Kenny-Z/ESE516Group/AtmelProject/document/Voodoo Magic.png

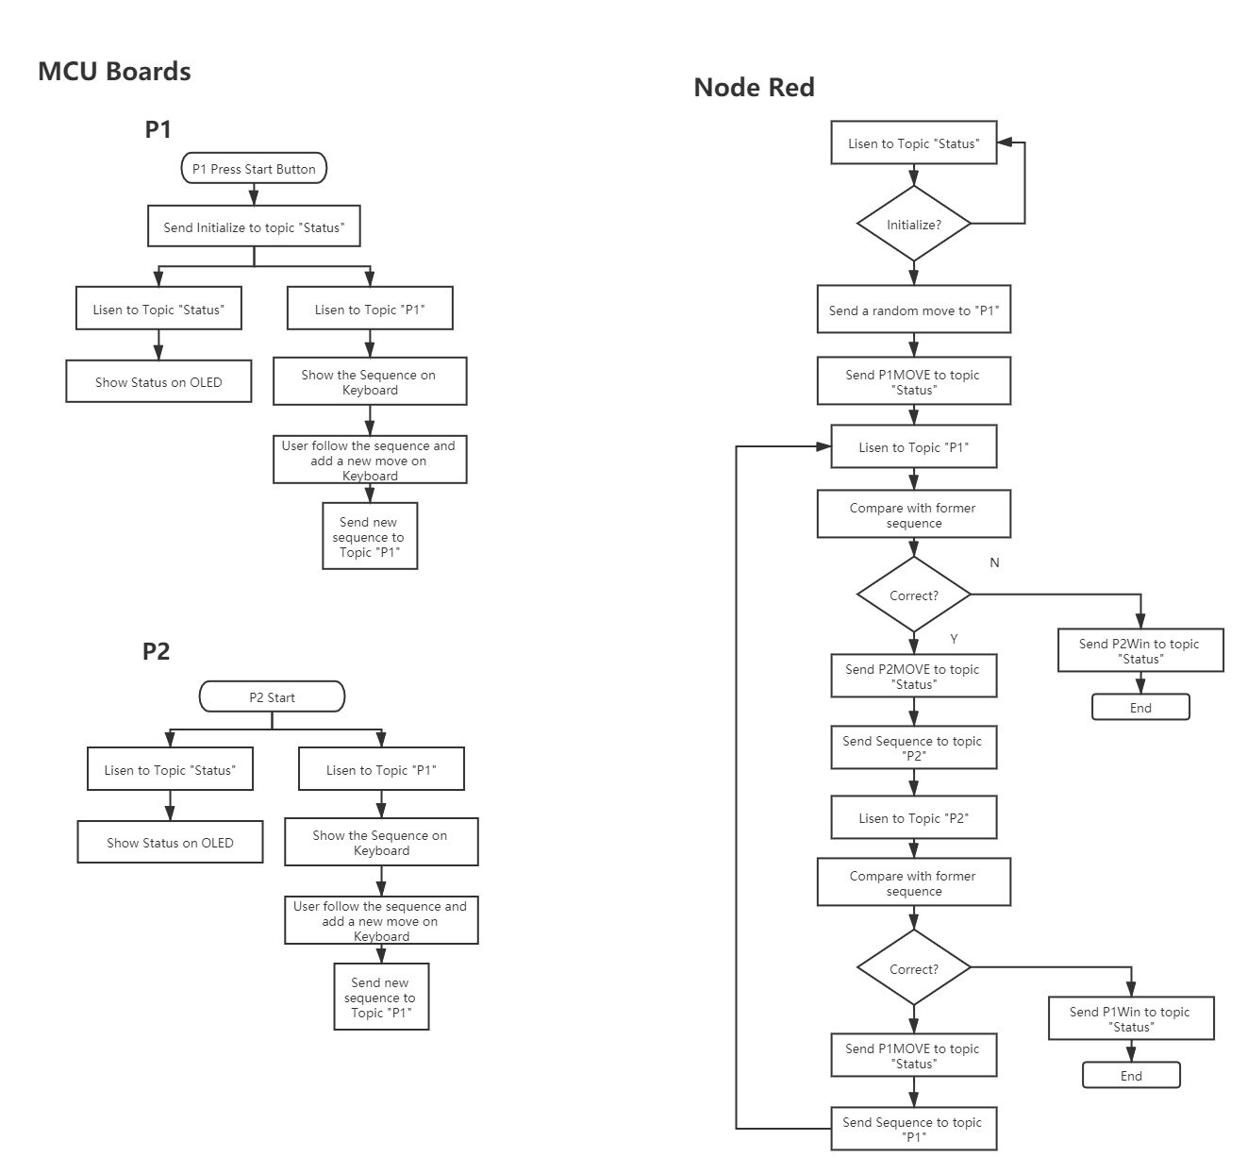
AtmelProject/document/Voodoo Magic.png
