Kenny-Z/ESE516Group/AltuimProject/VoodooMagic/Project Outputs for VoodooMagic/BOM/Bill of Materials-ESE516_ExampleProject.xlsx

Line # | Description | Designator | Quantity | Name | Manufacturer 1 | Manufacturer Part Number 1 | Manufacturer Lifecycle 1 | Supplier 1 | Supplier Part Number 1 | Supplier Unit Price 1 | Supplier Subtotal 1
 | DNP | DNP | 0 | Keypad | Adafruit Industries | 3954 |  | Digi-Key | 1528-2712-ND | 0 | 0
 | DNP | DNP | 0 | OLED Screen | SparkFun | LCD-14532 |  | Digi-Key | 1568-1819-ND | 0 | 0
16 | CAP 100nF 16V ±10% 0603 (1608 Metric) Thickness 1mm SMD | C1, C3, C7, C16 | 4 | 100nF 16V, CAP 100nF 16V 0603(1608) | Yageo | CC0603KRX7R7BB104 | Volume Production | Digi-Key | 311-1088-6-ND | 0.1 | 0.4
7 | CAP 10nF 16V ±10% 0603 (1608 Metric) Thickness 1mm SMD | C2 | 1 | 10nF 16V | Yageo | CC0603KRX7R7BB103 | Volume Production | Digi-Key | 311-3369-1-ND | 0.1 | 0.1
5 | CAP 4.7uF 16V -20% to +80% 0805 (2012 Metric) Thickness 1.45mm SMD | C4, C30, C31 | 3 | 4.7uF 16V | Yageo | CC0805KKX7R8BB475 | Volume Production | Digi-Key | 311-1885-6-ND | 0.42 | 1.26
 | CAP 100pF 50V ±20% 0603 (1608 Metric) Thickness 1mm SMD | C5, C6, C8, C9, C17, C19 | 6 | CAP 100pF 50V | KEMET | C0603C101M5GACTU | Volume Production | Digi-Key | 399-8981-6-ND | 0.1 | 0.6
4 | CAP 1uF 16V ±5% 0603 (1608 Metric) Thickness 1mm SMD | C10, C13, C29 | 3 | 1uF 16V | Yageo | CC0603KRX7R7BB105 | Volume Production | Digi-Key | 311-1446-6-ND | 0.15 | 0.45
8 | CAP 10uF 16V ±10% 0805 (2012 Metric) Thickness 1.45mm SMD | C11, C12 | 2 | 10uF 16V, CAP 10uF 16V 0805(2012) | Kyocera AVX | 0805YD106KAT2A | Volume Production | Digi-Key | 478-5165-1-ND | 0.39 | 0.78
9 | CAP 18pF 16V ±5% 0603 (1608 Metric) Thickness 1mm SMD | C14, C15 | 2 | 18pF 16V | KEMET | C0603C180J4GACTU | Volume Production | Digi-Key | 399-11141-1-ND | 0.25 | 0.5
 | CAP 1nF 10V ±1% 0603 (1608 Metric) Thickness 1mm SMD | C18 | 1 | CAP 1nF 10V | Yageo | CC0603KRX7R7BB102 | Volume Production | Digi-Key | 311-4063-1-ND | 0.1 | 0.1
 | Cap Ceramic, 47 uF, +/- 10%, -55 to 85 degC, 2-Pin SMD (1210), RoHS, Tape and Reel | C20, C21, C26, C27 | 4 | 47uF 16V | Murata | GRM32ER61C476KE15L | Volume Production | Digi-Key | 490-6539-6-ND | 0.63 | 2.52
 | CAP 100nF 10V ±5% 0603 (1608 Metric) Thickness 1mm SMD | C22, C25 | 2 | CAP 100nF 10V, 100nF 10V | Yageo | CC0402KRX7R7BB104 | Volume Production | Digi-Key | 311-1338-6-ND | 0.1 | 0.2
 | CAP 1uF 10V ±10% 0603 (1608 Metric) Thickness 1mm SMD | C23, C24 | 2 | 1uF 10V | Yageo | CC0603KPX7R8BB105 |  | Digi-Key | 13-CC0603KPX7R8BB105DKR-ND | 0.26 | 0.52
 | CAP 8.2nF 10V ±5% 0603 (1608 Metric) Thickness 1mm SMD | C28 | 1 | CAP 8.2nF 10V | Yageo | CC0603KRX7R9BB822 | Volume Production | Digi-Key | 311-1811-1-ND | 0.1 | 0.1
 | CAP 120pF 10V ±10% 0603 (1608 Metric) Thickness 1mm SMD | C32 | 1 | 120pF 10V | Yageo | CC0603KRX7R9BB121 | Volume Production | Digi-Key | 311-4094-1-ND | 0.1 | 0.1
 | Chip Capacitor, 22 uF, +/- 20%, 10 V, -55 to 85 degC, 0603 (1608 Metric), RoHS, Tape and Reel | C33 | 1 | 22uF 10V | TDK | C1608X5R1A226M080AC | Volume Production | Digi-Key | 445-9077-6-ND | 0.49 | 0.49
 | CAP 4.7uF 10V ±10% 0603 (1608 Metric) Thickness 0.55mm SMD | C34 | 1 | 4.7uF 10V | Yageo | CC0805KKX7R9BB225 | Volume Production | Digi-Key | 311-3420-6-ND | 1.06 | 1.06
 | CAP 1uF 10V ±10% 0402 (1005 Metric) Thickness 0.6mm SMD | C35 | 1 | 1uF 10V | Yageo | CC0603KRX7R7BB105 | Volume Production | Digi-Key | 311-1446-6-ND | 0.15 | 0.15
 | CAP 100nF 10V ±5% 0402 (1005 Metric) Thickness 0.6mm SMD | C36, C37 | 2 | 100nF 10V | Yageo | CC0603KRX7R8BB104 | Volume Production | Digi-Key | 311-1341-1-ND | 0.1 | 0.2
30 | LED Uni-Color Red, 100 mW, 200 mA, -55 to 85 degC, 2-Pin SMD, RoHS, Tape and Reel | D1, D4 | 2 | LTST-C170CKT | Vishay Lite-On | LTST-C170CKT | Volume Production | Digi-Key | 160-1176-1-ND | 0.35 | 0.7
34 | Ultra Low Capacitance Double Rail-to-Rail ESD Protection Diode, 5.5 V, 1 pF, -40 to 85 degC, 4-Pin SOT143B, RoHS, Tape and Reel | D2 | 1 | PRTR5V0U2X,215 | Nexperia | PRTR5V0U2X,215 |  | Digi-Key | 1727-3884-6-ND | 0.48 | 0.48
 | LED RED DIFFUSED 0805 SMD | D3 | 1 | LH R974-LP-1 | Osram Opto | LH R974-LP-1 | Volume Production | Digi-Key | 475-1415-1-ND | 0.26 | 0.26
31 | LED Uni-Color Green, 100 mW, 120 mA, -55 to 85 degC, 2-Pin SMD, RoHS, Tape and Reel | D5 | 1 | LTST-C170GKT | Vishay Lite-On | LTST-C170GKT | Volume Production | Digi-Key | 160-1179-1-ND | 0.3 | 0.3
24 | Chip Ferrite Bead for Power Lines, 220 Ohm, 2000 mA, -55 to 125 degC, 2 x 1.25 x 1.05 mm SMD, Tape and Reel | FB1 | 1 | BLM21PG221SN1D | Murata | BLM21PG221SN1D | Volume Production | Digi-Key | 490-1054-6-ND | 0.1 | 0.1
13 | Fiducial 40x100mm | FD1, FD2, FD3 | 3 | 40x100mm
39 | Connector; USBMicro-B,Reverse type, SMT; 5 Position; Right Angle | J1 | 1 | ZX62R-B-5P | Hirose | ZX62R-B-5P(30) | Volume Production | Digi-Key | H125274CT-ND | 1.02 | 1.02
 | BOURNS - SRP6540-1R0M - Cewka mocy (SMD), 1 µH, 12 A, Osloniete, 13.5 A, Seria SRP6540, 7.2mm x 6.5mm x 4mm | L1 | 1 | 1uH |  |  |  | Digi-Key | SRP6540-1R0MCT-ND
 | FIXED IND 470NH 1.2A 90 MOHM SMD | L2 | 1 | 470nH | TDK | MLP2012SR47MT0S1 | Volume Production | Digi-Key | 445-6367-1-ND | 0.33 | 0.33
20 | Male Header, Pitch 2.54 mm, 1 x 3 Position, Height 10.03 mm, Tail Length 3.56 mm, -55 to 105 degC | P1, P5 | 2 | 640456-3 | Molex | 22-11-2032 | Volume Production | Digi-Key | WM2701-ND | 0.53 | 1.06
 | Male Header, Pitch 2.54 mm, 1 x 4 Position, Height 10.03 mm, Tail Length 3.56 mm, RoHS, Bulk | P2, P3, P4 | 3 | 640456-4 | TE Connectivity | 640456-4 | Volume Production | Digi-Key | A1922-ND | 0.24 | 0.72
1 | 0.1" Pad | PB22, PB23, Reset, TP1, TP2, TP3, TP4 5V5, TP5, TP6, TP7, TP9, TP10 3V3, TP11, TP12, TP13, TP14, TP15, TP16, TP17, TP19, TP20, TP21, TP22, TP23, TP24 | 25 | 0.1" Pad | DNP | DNP | DNP | DNP | DNP | DNP
11 | 27R 0.1W 1% 0603 (1608 Metric) SMD | R1, R2, R19, R20, R21 | 5 | 27R 1% | Stackpole Electronics | RMCF0603JT27R0 | Volume Production | Digi-Key | RMCF0603JT27R0DKR-ND | 0.014 | 0.14
3 | 1K 0.1W 1% 0603 (1608 Metric) SMD | R3, R5, R9, R17, R33, R34 | 6 | 1K 1% | Stackpole Electronics | RMCF0603FG1K00 | Volume Production | Digi-Key | RMCF0603FG1K00CT-ND | 0.016 | 0.16
28 | Jumper 0603 (1608 Metric) | R4 | 1 | Jumper | Yageo | RC0603JR-070RL | Volume Production | Digi-Key | 311-0.0GRCT-ND | 0.1 | 0.1
29 | Jumper 0805 (2012 Metric) | R6, R7, R8, R14, R15, R16, R18 | 7 | Jumper | Yageo | RC0805JR-070RL | Volume Production | Digi-Key | 311-0.0ARDKR-ND | 0.031 | 0.31
 | 4K7 0.063W 1% 0402 (1005 Metric) SMD | R10, R11, R12, R13 | 4 | 4K7 1% | Stackpole Electronics | RMCF0402FT4K70 | Volume Production | Arrow Electronics | RMCF0402FT4K70 | 0.021 | 0.084
 | Chip Resistor, 10 KOhm, +/- 1%, 0.1 W, -55 to 155 degC, 0603 (1608 Metric), RoHS, Tape and Reel | R22, R24, R26, R27 | 4 | ERJ3EKF1002V | Stackpole Electronics | RMCF0402FT10K0 | Volume Production | Digi-Key | RMCF0402FT10K0CT-ND | 0.014 | 0.14
17 | 100R 0.1W 1% 0603 (1608 Metric) SMD | R23, R25 | 2 | 100R 1% | Stackpole Electronics | RMCF0603FG100R | Volume Production | Digi-Key | RMCF0603FG100RCT-ND | 0.016 | 0.16
 | 23K7 0.063W 1% 0402 (1005 Metric) SMD | R28 | 1 | 23K7 1% | Stackpole Electronics | RMCF0603FT23K7 | Volume Production | Digi-Key | RMCF0603FT23K7DKR-ND | 0.1 | 0.1
 | 86K6 0.063W 1% 0402 (1005 Metric) SMD | R29 | 1 | 86K6 1% | Stackpole Electronics | RMCF0402FT86K6 | Volume Production | Digi-Key | RMCF0402FT86K6DKR-ND | 0.1 | 0.1
 | 140K 0.063W 1% 0402 (1005 Metric) SMD | R30 | 1 | 140K 1% | Stackpole Electronics | RMCF0402FT140K | Volume Production | Digi-Key | 738-RMCF0402FT140KCT-ND | 0.1 | 0.1
 | 309K 0.063W 1% 0402 (1005 Metric) SMD | R31 | 1 | 309K 1% | Stackpole Electronics | RMCF0402FT309K | Volume Production | Digi-Key | RMCF0402FT309KDKR-ND | 0.1 | 0.1
 | 453K 0.063W 1% 0402 (1005 Metric) SMD | R32, R37 | 2 | 453K 1% | Stackpole Electronics | RMCF0402FT453K | Volume Production | Digi-Key | RMCF0402FT453KDKR-ND | 0.014 | 0.14
2 | 1K13 0.1W 1% 0603 (1608 Metric) SMD | R35, R36 | 2 | 1K13 1% | Stackpole Electronics | RMCF0603FT1K13 | Volume Production | Digi-Key | RMCF0603FT1K13DKR-ND | 0.016 | 0.16
 | 100K 0.063W 1% 0402 (1005 Metric) SMD | R38, R39 | 2 | 100K 1% 0402 | Stackpole Electronics | RMCF0402FT100K | Volume Production | Digi-Key | RMCF0402FT100KDKR-ND | 0.014 | 0.14
 | 10R 0.063W 1% 0402 (1005 Metric) SMD | R40 | 1 | 10R 1% | Stackpole Electronics | RMCF0402JT10R0 | Volume Production | Arrow Electronics | RMCF0402JT10R0 | 0.0132 | 0.0132
 | RES Thick Film, 10kΩ, 1%, 0.063W, 100ppm/°C, 0402 | R41 | 1 | 10k 1% | Stackpole Electronics | RMCF0402FT10K0 | Volume Production | Digi-Key | RMCF0402FT10K0DKR-ND | 0.1 | 0.1
19 | Micro SD Card, RA, -25 to 85 degC, 8-Pin SMD, RoHS, Tape and Reel | SD1 | 1 | 104031-0811 | Molex | 1040310811 | Volume Production | Digi-Key | WM6357DKR-ND | 1.83 | 1.83
 | SWITCH TACTILE SPST-NO 0.05A 16V | SW1, SW2 | 2 | PTS810 SJG 250 SMTR LFS | ITT C&K | PTS810SJG250SMTRLFS | Volume Production | Digi-Key | CKN10504CT-ND | 0.37 | 0.74
27 | FT234XD USB to BASIC UART IC, -40 to +85 degC, 12-Pin DFN, Pb-Free, Tape and Reel | U1 | 1 | FT234XD-R | FTDI | FT234XD-R | Volume Production | Digi-Key | 768-1178-1-ND | 2.04 | 2.04
21 | CONN HEADER 10POS UNSHD VERT T/H | U2 | 1 | 20021111-00010T4LF | Amphenol FCI | 20021111-00010T4LF | Volume Production | Digi-Key | 609-3712-ND | 0.73 | 0.73
36 | RF TXRX MODULE WIFI TRACE ANT | U3 | 1 | SAMW25H18-MR510PB | Microchip / Atmel | ATSAMW25H18-MR510PB | Volume Production | Digikey | ATSAMW25H18-MR510PB-ND
 | IC REG BOOST ADJ 10A 20VQFN | U4 | 1 | TPS61088RHLT | Texas Instruments | TPS61088RHLT | New Product | Digi-Key | 296-42129-1-ND | 4.55 | 4.55
 | USB-Friendly Li-Ion Battery Charger and Power-Path Management IC, Vout 5.5 V, 4.3 V, -40 to 85 degC, 16-pin QFN (RGT), Green (RoHS & no Sb/Br) | U5 | 1 | BQ24075RGTR | Texas Instruments | BQ24075RGTR | Volume Production | Digi-Key | 296-38874-6-ND | 2.19 | 2.19
 | 2.4V-5.5V input, 4A step-down converter with 1% Accuracy in 1.5mm x 1.5mm QFN 6-VSON-HR -40 to 125 | U6 | 1 | TPS62827DMQR | Texas Instruments | TPS62827DMQR |  | Digi-Key | 296-TPS62827DMQRCT-ND
 | Sensor Controller Capacitive 3-CH I2C 8-Pin SOIC T/R | U7 | 1 | I2C Touch Sensor | Microchip | CAP1203-1-SN-TR | Not Recommended for New Design | Digi-Key | CAP1203-1-SN-CT-ND | 0.55 | 0.55
 | HIGH ACCURACY AMBIENT LIGHT SENS | U8 | 1 | I2C Light Sensor | Vishay Semiconductors | VEML6030-GS15 |  | Digi-Key | VEML6030-GS15CT-ND | 2 | 2
22 | Crystal, 32.768 kHz, 12.5 pF, -40 to 85 degC, SMD Low Profile 3.2 x 1.5 x 0.9 mm, Tape and Reel | X1 | 1 | ABS07-32.768KHz-T | Micro Crystal | CC7V-T1A-32.768KHZ-12.5PF-20PPM-TA-QC |  | Digi-Key | 2195-CC7V-T1A-32.768KHZ-12.5PF-20PPM-TA-QCCT-ND | 0.61 | 0.61
