Kenny-Z/ESE516Group/AltuimProject/VoodooMagic/Project Outputs for VoodooMagic/VoodooMagic_V1_Documentation.PDF

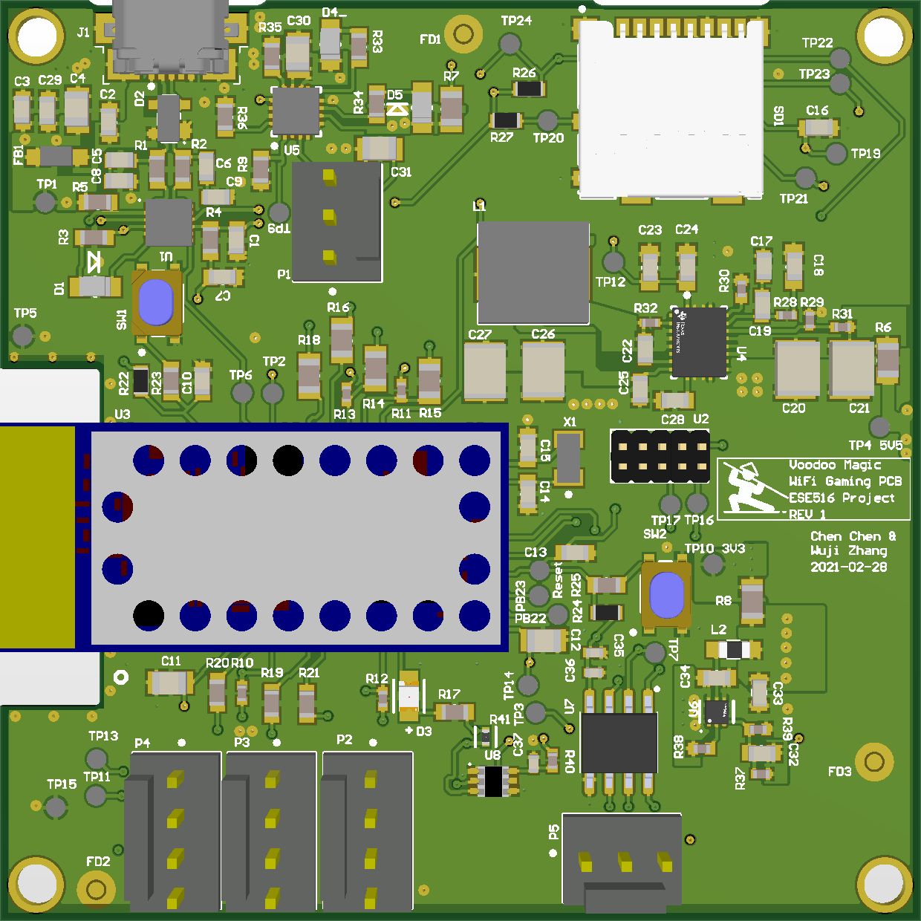
[picture p45: page 1]

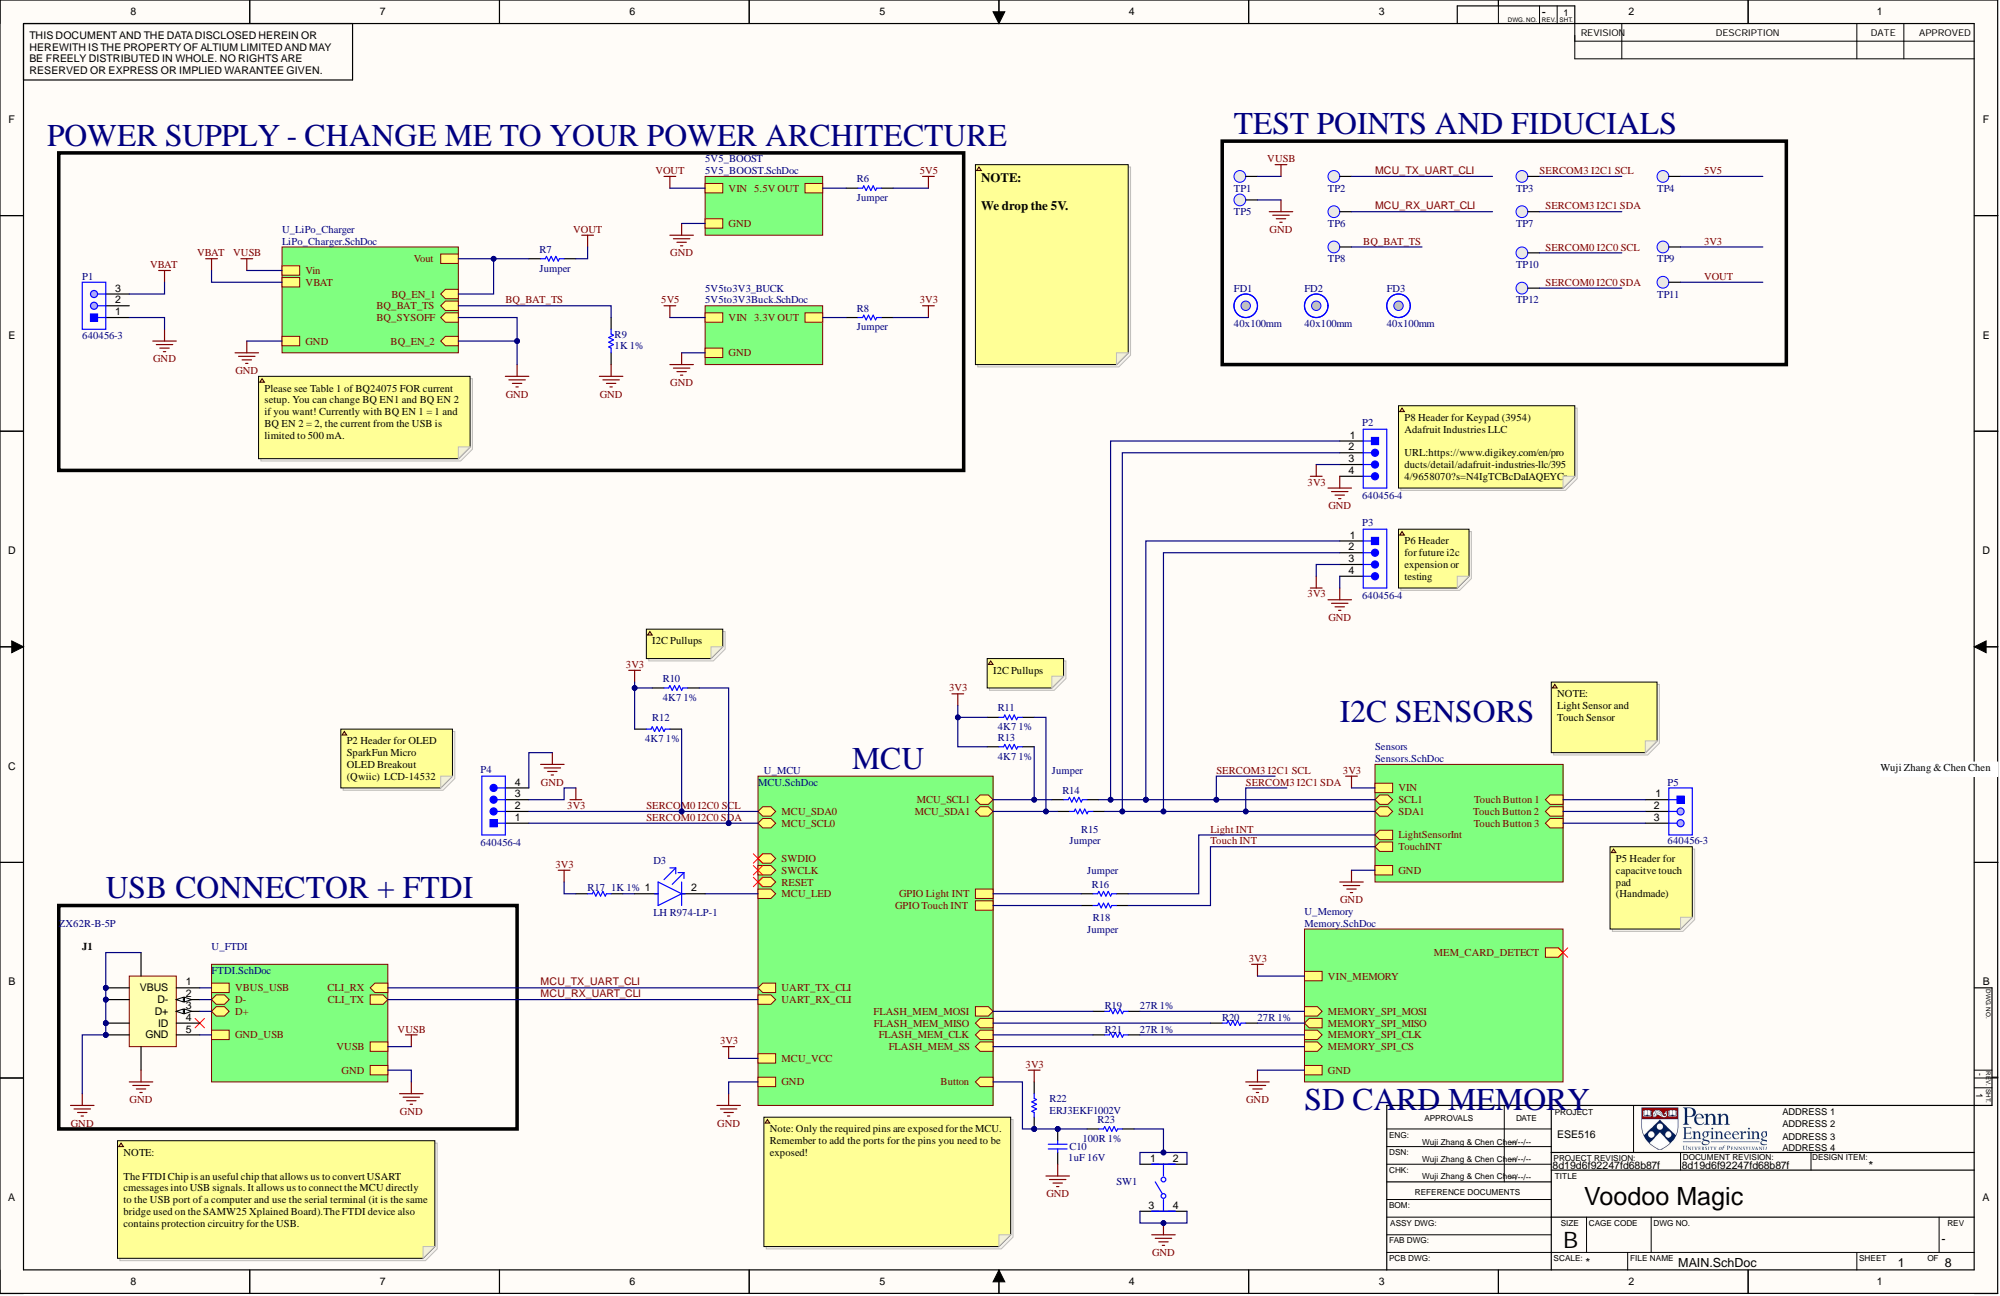
[picture p46: page 2]

DWG. NO. | -REV. | 1 SHT.

THIS DOCUMENT AND THE DATA DISCLOSED HEREIN OR HEREWITH IS THE PROPERTY OF ALTIUM LIMITED AND MAY BE FREELY DISTRIBUTED IN WHOLE. NO RIGHTS ARE RESERVED OR EXPRESS OR IMPLIED WARANTEE GIVEN. POWER SUPPLY - CHANGE ME TO YOUR POWER ARCHITECTURE | TEST POINTS AND FIDUCIALS | REVISION | DESCRIPTION | DATE | APPROVED

GND
Please see Table 1 of BQ24075 FOR current
setup. You can change BQ EN1 and BQ EN 2
if you want! Currently with BQ EN 1 = 1 and
BQ EN 2 = 2, the current from the USB is
limited to 500 mA.

URL:https://www.digikey.com/en/pro
ducts/detail/adafruit-industries-llc/395
4/9658070?s=N4IgTCBcDaIAQEYCs

SERCOM3 I2C1 SCL | 3

Wuji Zhang & Chen Chen

REV. SHT. DWG. NO.

Note: Only the required pins are exposed for the MCU.
Remember to add the ports for the pins you need to be
exposed!

DSN: Wuji Zhang & Chen Chen | --/--/--

8d19d6f92247fd68b87f | DOCUMENT REVISION: 8d19d6f92247fd68b87f | DESIGN ITEM: * PROJECT REVISION:

CHK: Wuji Zhang & Chen Chen | --/--/--

The FTDI Chip is an useful chip that allows us to convert USART
cmessages into USB signals. It allows us to connect the MCU directly
to the USB port of a computer and use the serial terminal (it is the same
bridge used on the SAMW25 Xplained Board).The FTDI device also
contains protection circuitry for the USB.

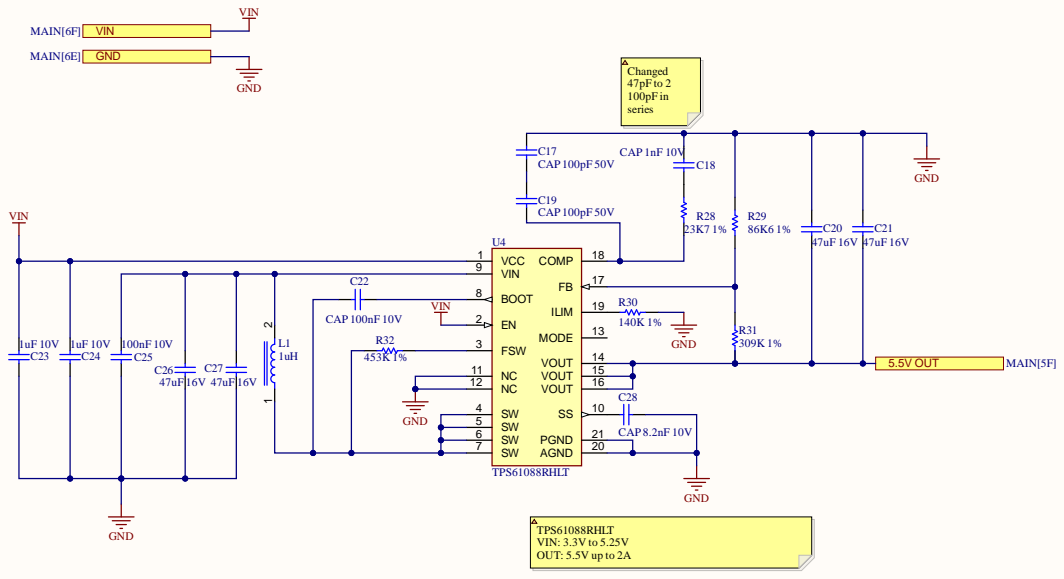
[picture p47: page 3]

DWG. NO. | -REV. | 2 SHT.

THIS DOCUMENT AND THE DATA DISCLOSED HEREIN OR HEREWITH IS THE PROPERTY OF ALTIUM LIMITED AND MAY BE FREELY DISTRIBUTED IN WHOLE. NO RIGHTS ARE RESERVED OR EXPRESS OR IMPLIED WARANTEE GIVEN. | | REVISION | DESCRIPTION | DATE | APPROVED

R32
453K 1% | NC 11

REV. SHT. DWG. NO.

DATE | PROJECT * | ADDRESS 1 ADDRESS 2 APPROVALS ADDRESS 3 ADDRESS 4

ENG: * | --/--/--

DSN: Wuji Zhang | --/--/--

8d19d6f92247fd68b87f | DOCUMENT REVISION: 8d19d6f92247fd68b87f | DESIGN ITEM: * PROJECT REVISION:

CHK: Wuji Zhang | --/--/--

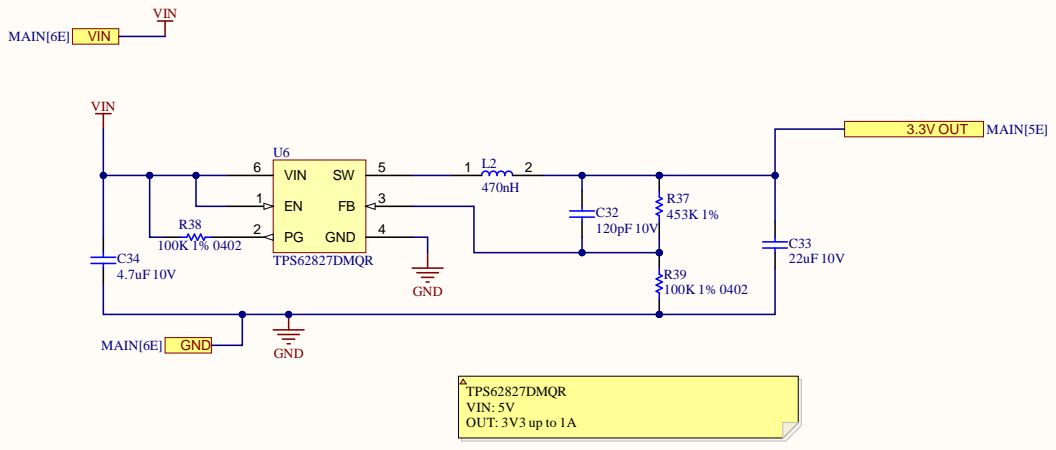
[picture p48: page 4]

DWG. NO. | -REV. | 3 SHT.

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

REV. SHT. DWG. NO.

DATE | PROJECT * | ADDRESS 1 ADDRESS 2 APPROVALS ADDRESS 3 ADDRESS 4

ENG: Wuji Zhang | --/--/--

DSN: Wuji Zhang | --/--/--

8d19d6f92247fd68b87f | DOCUMENT REVISION: 8d19d6f92247fd68b87f | DESIGN ITEM: * PROJECT REVISION:

CHK: Wuji Zhang | --/--/--

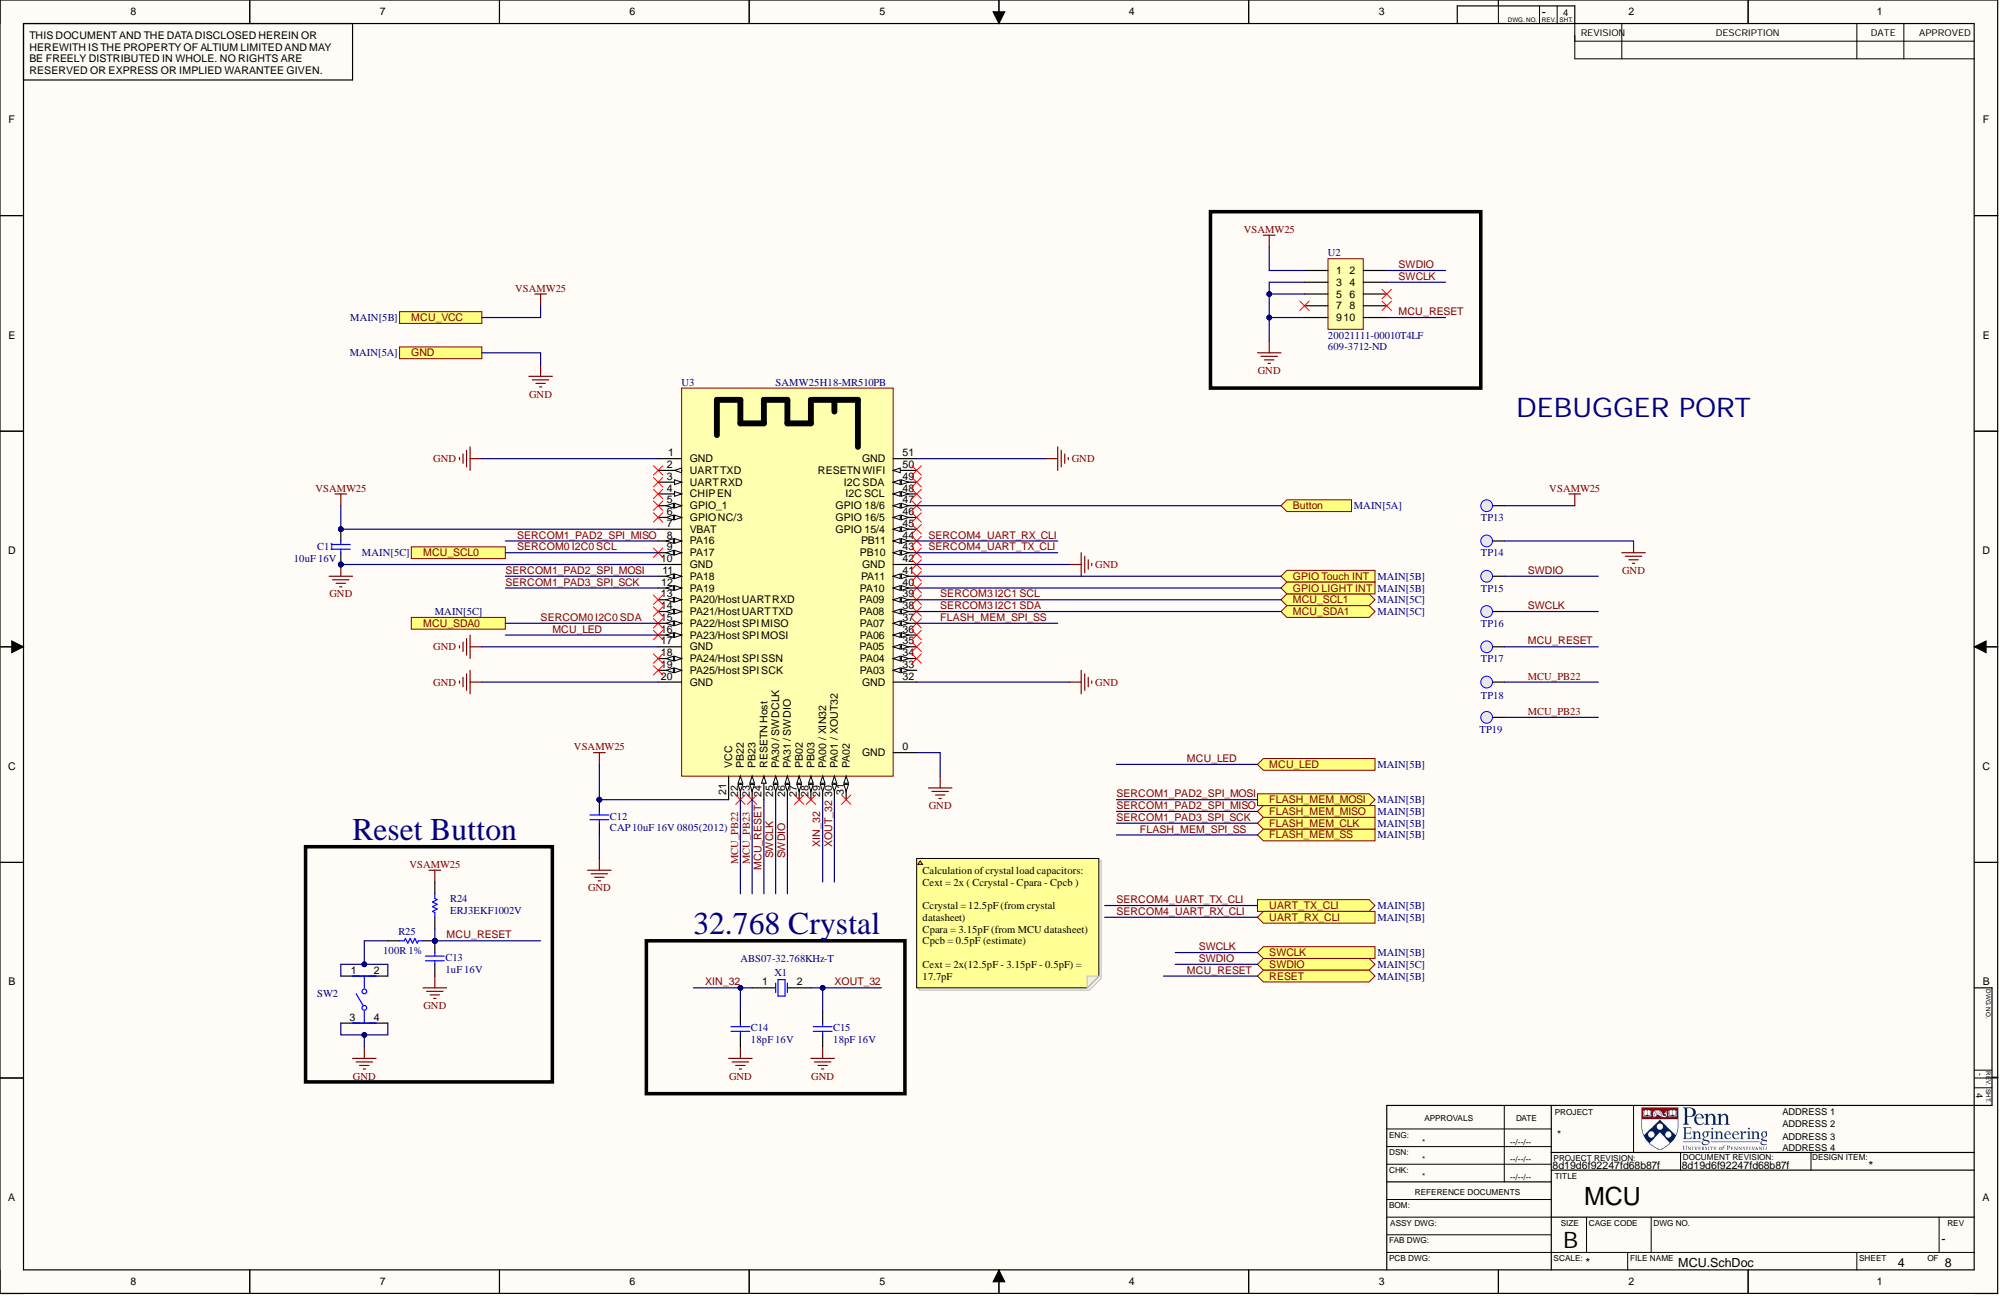
[picture p49: page 5]

DWG. NO. | -REV. | 4 SHT.

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

GPIO Touch INT MAIN[5B]
GPIO LIGHT INT MAIN[5B]

Calculation of crystal load capacitors:
Cext = 2x ( Ccrystal - Cpara - Cpcb )

Ccrystal = 12.5pF (from crystal
datasheet)
Cpara = 3.15pF (from MCU datasheet)
Cpcb = 0.5pF (estimate)

REV. SHT. DWG. NO.

DATE | PROJECT * | ADDRESS 1 ADDRESS 2 APPROVALS ADDRESS 3 ADDRESS 4

ENG: * | --/--/--

DSN: * | --/--/--

8d19d6f92247fd68b87f | DOCUMENT REVISION: 8d19d6f92247fd68b87f | DESIGN ITEM: * PROJECT REVISION:

CHK: * | --/--/--

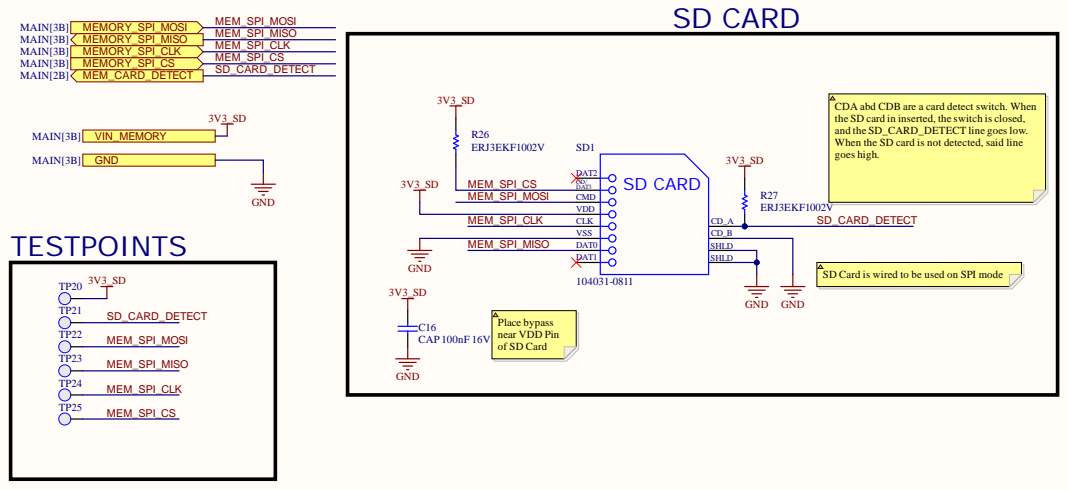
[picture p50: page 6]

DWG . N O . | -R E V | 5 . S H T.

T H IS DOC U MEN T AN D T HE ATA ISCLOSED HEREI N OR HEREW I T H IS T HE PROPER TY OF ALT I U M LI M I TED AN M AY BE F REELY IST R IBU TED I N W HOLE. NO R IGH TS ARE RESERVED OR EXPRESS OR I MPLIED WARAN TEE GIVEN . | | REVISI O N | DESC R IPT I O N | DAT E | APPR OVED

REV. SHT. DWG. NO.

DATE | PRO JECT * | AD D RESS 1 2 APPROVALS AD D RESS AD D RESS 3 AD D RESS 4

ENG : Wu j i Zh a n g | --/--/--

DSN: Wu j i Zh a n g | --/--/--

8d19d6f92247fd68b 8 7 f | DOCUMENT REVISION: 8d19d6f92247fd68b 8 7 f | DESIGN ITEM: * PROJECT REVISION:

CHK: Wu j i Zh a n g | --/--/--

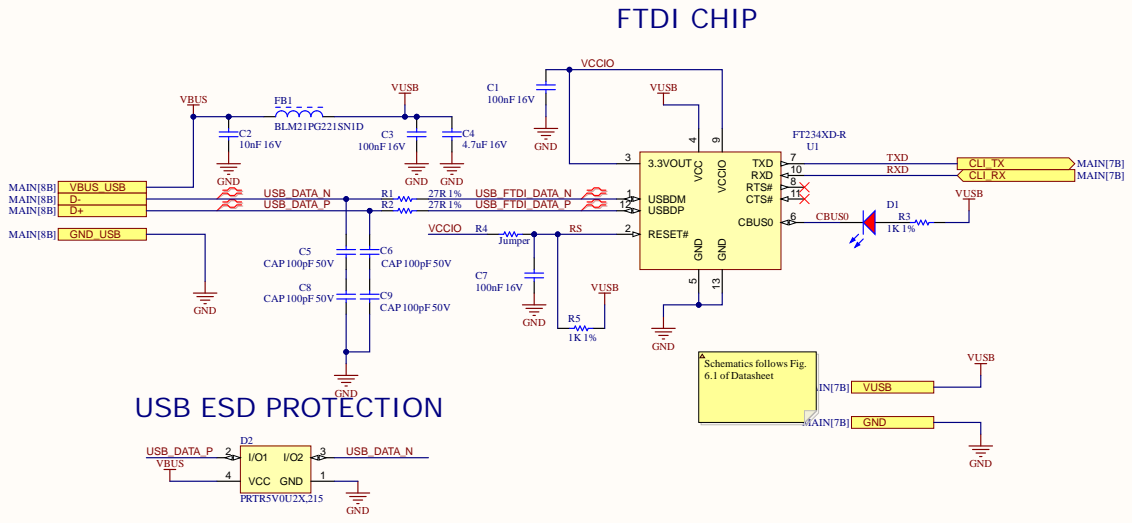
[picture p51: page 7]

DWG. NO. | -REV. | 6 SHT.

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

REV. SHT. DWG. NO.

DATE | PROJECT * | ADDRESS 1 ADDRESS 2 APPROVALS ADDRESS 3 ADDRESS 4

ENG: Wuji Zhang | --/--/--

DSN: Wuji Zhang | --/--/--

8d19d6f92247fd68b87f | DOCUMENT REVISION: 8d19d6f92247fd68b87f | DESIGN ITEM: * PROJECT REVISION:

CHK: Wuji Zhang | --/--/--

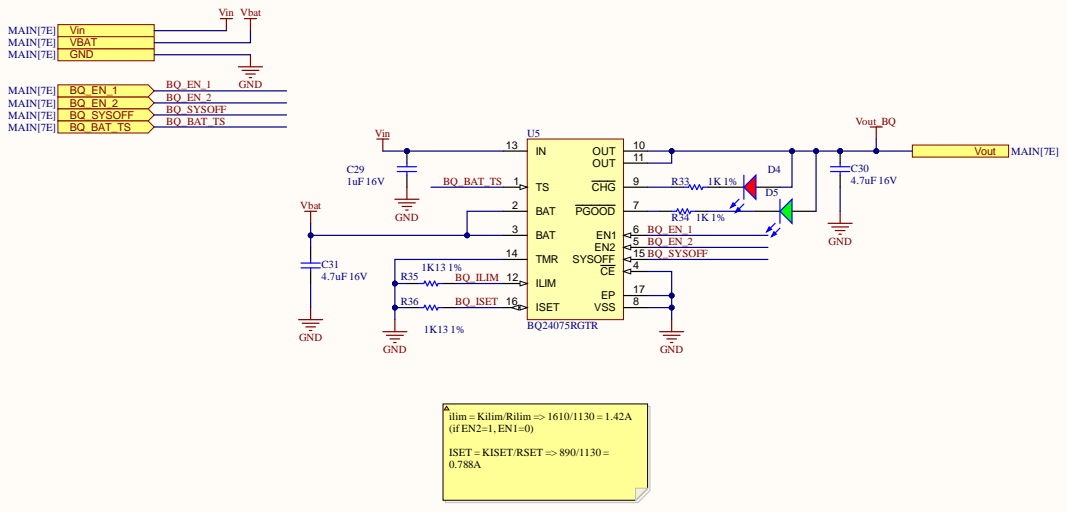
[picture p52: page 8]

DWG . N O . | -R E V | 7 . S H T.

T H IS DOC U MEN T AN T HE ATA ISCLOSED HEREI N OR HEREW I T H IS T HE PROPER TY OF ALT I U M LI M I TED AN M AY BE F REELY IST R IBU TED I N W HOLE. NO R IGH TS ARE RESERVED OR EXPRESS OR I MPLIED WARAN TEE GIVEN . | | REVISI O N | DESC R IPT I O N | DAT E | APPR OVED

1 K 1 3 1 % R3 5 BQ _ILIM

REV. SHT. DWG. NO.

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

ENG : Wu j i Zh a n g | --/--/--

DSN: Wu j i Zh a n g | --/--/--

8d19d6f92247fd68b 8 7 f | DOCUMENT REVISION: 8d19d6f92247fd68b 8 7 f | DESIGN ITEM: * PROJECT REVISION:

CHK: Wu j i Zh a n g | --/--/--

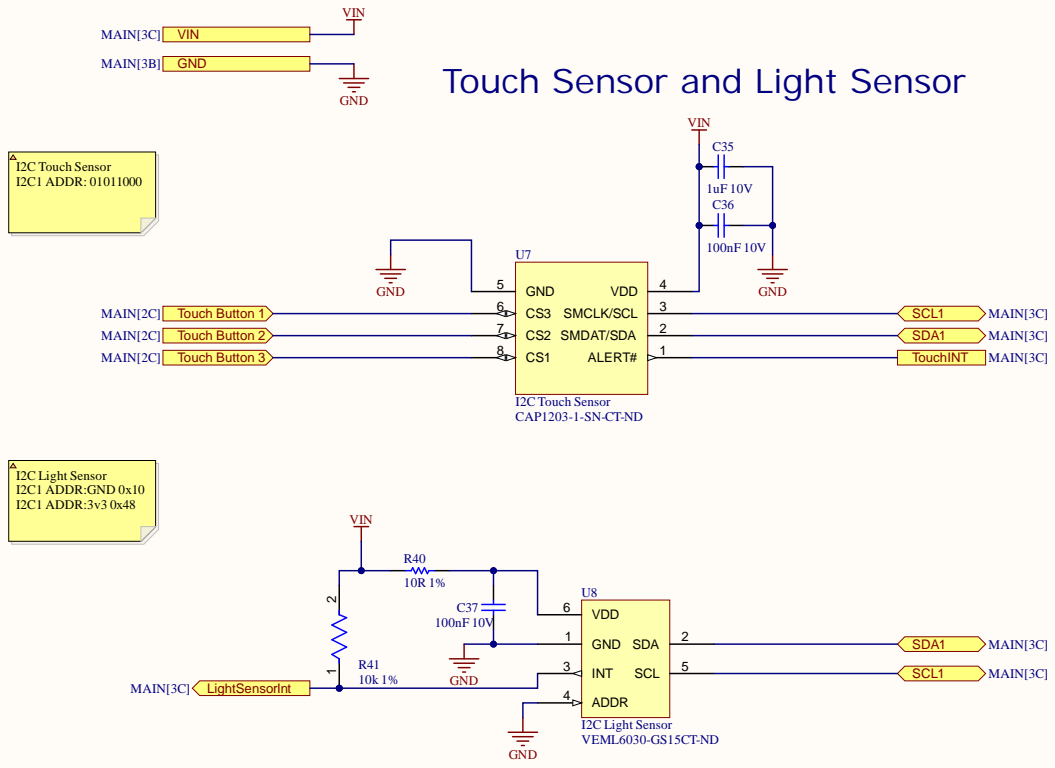
[picture p53: page 9]

DWG. NO. | -REV. | 8 SHT.

THIS DOCUMENT AND THE DATA DISCLOSED HEREIN OR HEREWITH IS THE PROPERTY OF ALTIUM LIMITED AND MAY BE FREELY DISTRIBUTED IN WHOLE. NO RIGHTS ARE RESERVED OR EXPRESS OR IMPLIED WARANTEE GIVEN. | VIN | REVISION | DESCRIPTION | DATE | APPROVED

Touch Sensor and Light Sensor

REV. SHT. DWG. NO.

DATE | PROJECT * | ADDRESS 1 ADDRESS 2 APPROVALS ADDRESS 3 ADDRESS 4

ENG: Wuji Zhang | --/--/--

DSN: Wuji Zhang | --/--/--

8d19d6f92247fd68b87f | DOCUMENT REVISION: 8d19d6f92247fd68b87f | DESIGN ITEM: * PROJECT REVISION:

CHK: Wuji Zhang | --/--/--

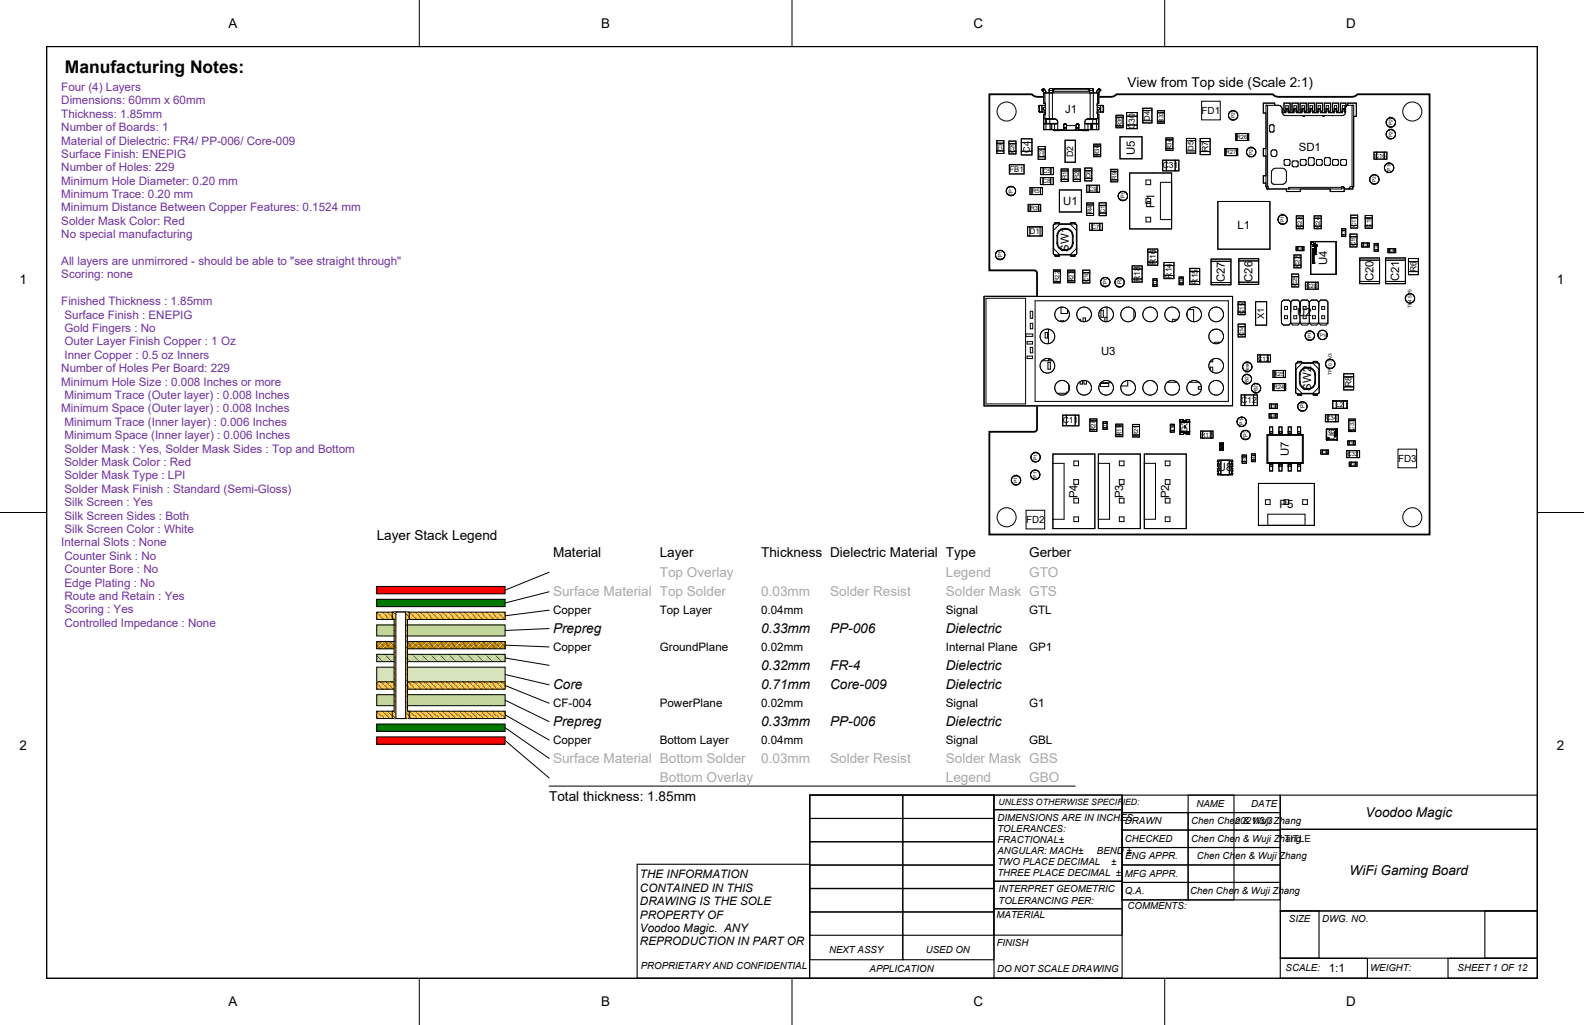
[picture p54: page 10]

Manufacturing Notes:
Four (4) Layers
Dimensions: 60mm x 60mm
Thickness: 1.85mm
Number of Boards: 1
Material of Dielectric: FR4/ PP-006/ Core-009
Surface Finish: ENEPIG
Number of Holes: 229

View from Top side (Scale 2:1)

Minimum Hole Diameter: 0.20 mm
Minimum Trace: 0.20 mm
Minimum Distance Between Copper Features: 0.1524 mm
Solder Mask Color: Red
No special manufacturing

All layers are unmirrored - should be able to "see straight through"
Scoring: none

Finished Thickness : 1.85mm
Surface Finish : ENEPIG
Gold Fingers : No
Outer Layer Finish Copper : 1 Oz
Inner Copper : 0.5 oz Inners
Number of Holes Per Board: 229
Minimum Hole Size : 0.008 Inches or more
Minimum Trace (Outer layer) : 0.008 Inches
Minimum Space (Outer layer) : 0.008 Inches
Minimum Trace (Inner layer) : 0.006 Inches
Minimum Space (Inner layer) : 0.006 Inches

Solder Mask : Yes, Solder Mask Sides : Top and Bottom
Solder Mask Color : Red
Solder Mask Type : LPI
Solder Mask Finish : Standard (Semi-Gloss)
Silk Screen : Yes
Silk Screen Sides : Both
Silk Screen Color : White
Internal Slots : None
Counter Sink : No
Counter Bore : No
Edge Plating : No
Route and Retain : Yes
Scoring : Yes
Controlled Impedance : None

UNLESS OTHERWISE SPECIFIED: | | NAME | DATE | Voodoo Magic
DIMENSIONS ARE IN INCHES TOLERANCES: FRACTIONAL± ANGULAR: MACH± BEND ± TWO PLACE DECIMAL ± THREE PLACE DECIMAL ± | DRAWN | Chen Chen & Wuji Zhang | 2021/3/3

CHECKED | Chen Chen & Wuji Zhang | | TITLE WiFi Gaming Board
ENG APPR. | Chen Chen & Wuji Zhang

THE INFORMATION CONTAINED IN THIS DRAWING IS THE SOLE PROPERTY OF Voodoo Magic. ANY REPRODUCTION IN PART OR PROPRIETARY AND CONFIDENTIAL | | | MFG APPR.

INTERPRET GEOMETRIC TOLERANCING PER: | Q.A. | Chen Chen & Wuji Zhang

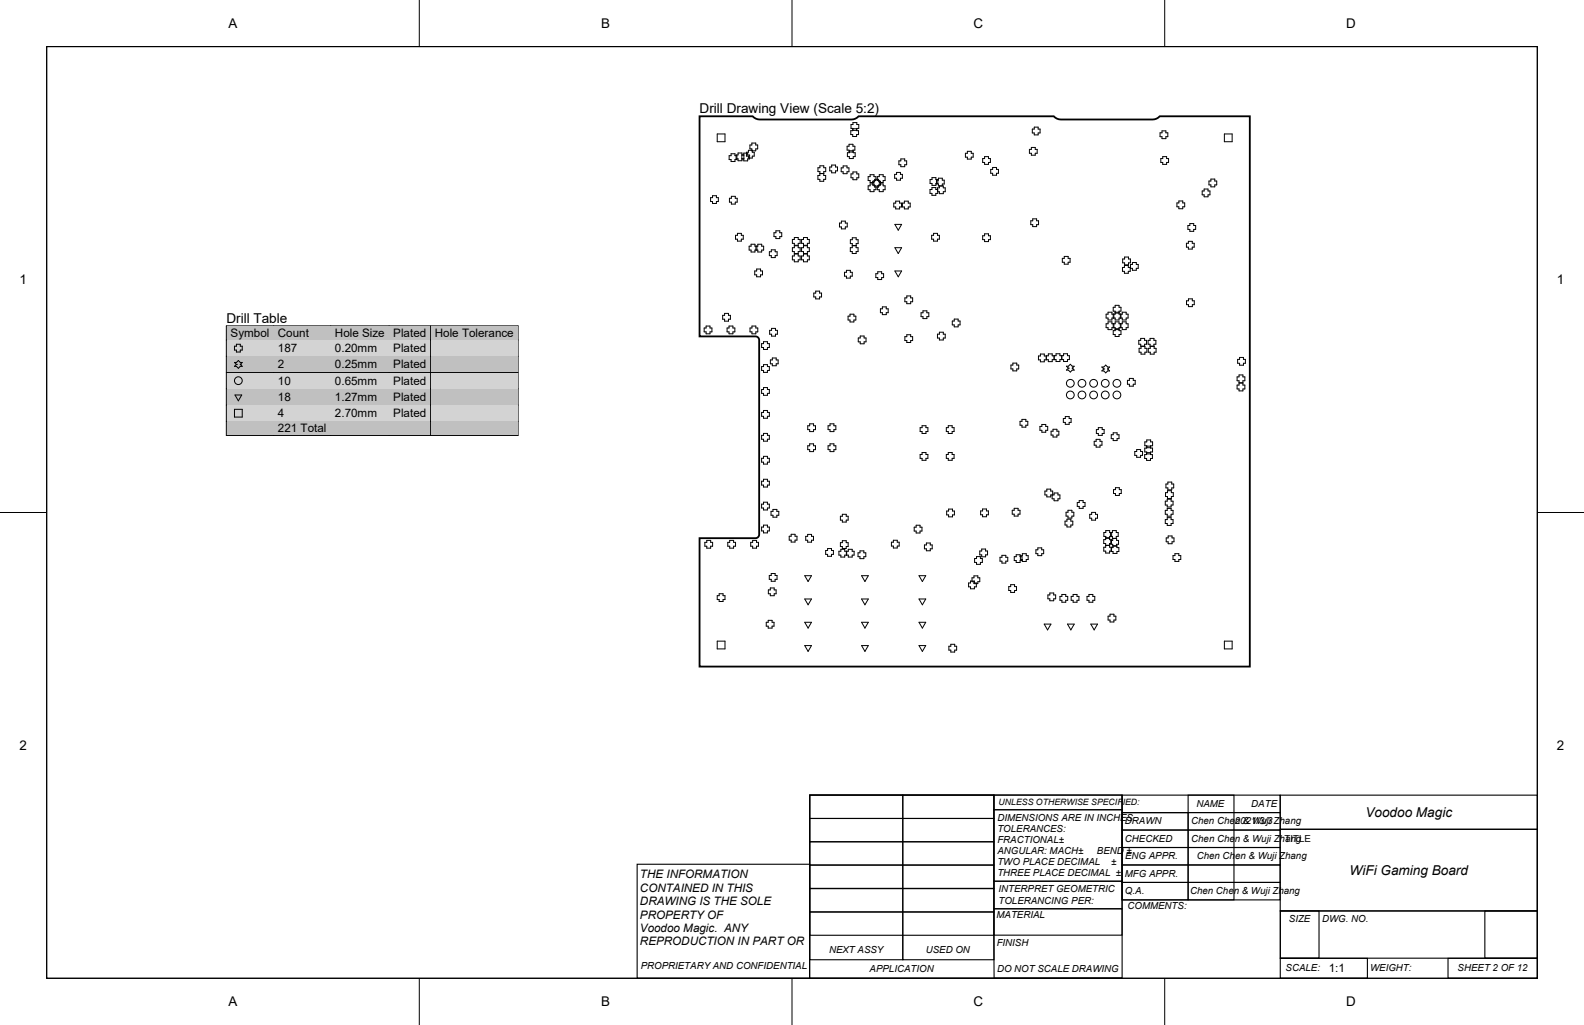
[picture p55: page 11]

Drill Drawing View (Scale 5:2)

Symbol | Count | Hole Size | Plated | Hole Tolerance

187 | 0.20mm | Plated
2 | 0.25mm | Plated
10 | 0.65mm | Plated
18 | 1.27mm | Plated
4 | 2.70mm | Plated
221 Total

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

CHECKED | Chen Chen & Wuji Zhang | | TITLE WiFi Gaming Board
ENG APPR. | Chen Chen & Wuji Zhang

THE INFORMATION CONTAINED IN THIS DRAWING IS THE SOLE PROPERTY OF Voodoo Magic. ANY | | | MFG APPR.

INTERPRET GEOMETRIC TOLERANCING PER: | Q.A. | Chen Chen & Wuji Zhang

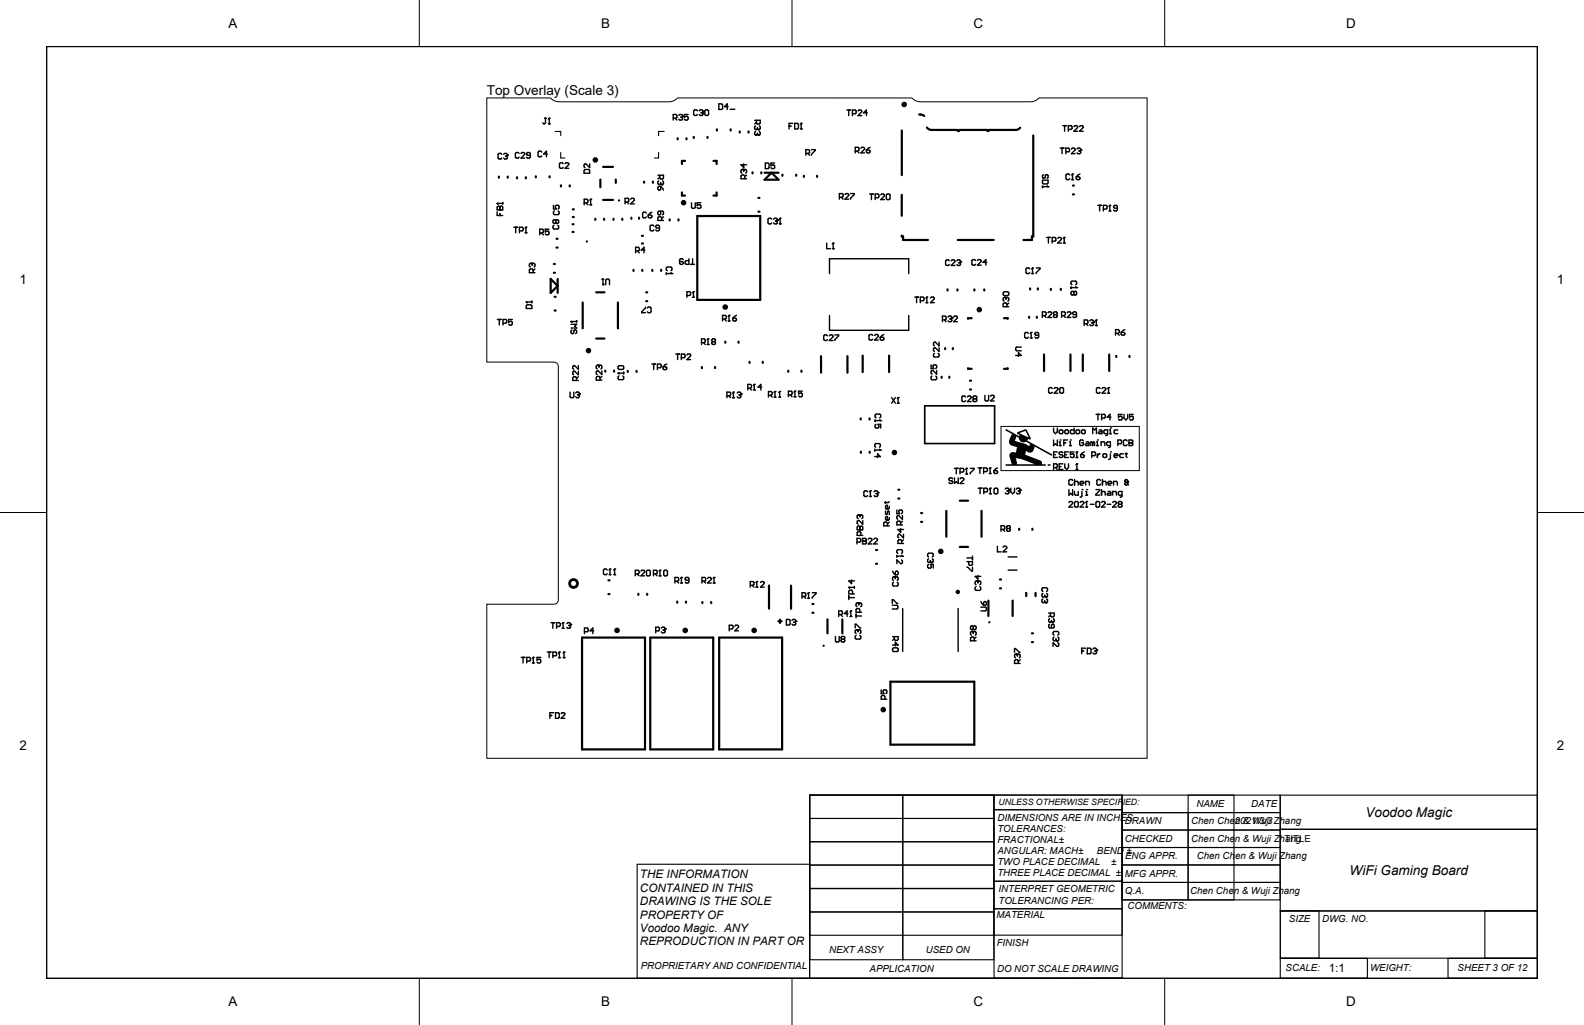
[picture p56: page 12]
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

CHECKED | Chen Chen & Wuji Zhang | | TITLE WiFi Gaming Board
ENG APPR. | Chen Chen & Wuji Zhang

THE INFORMATION CONTAINED IN THIS DRAWING IS THE SOLE PROPERTY OF Voodoo Magic. ANY | | | MFG APPR.

INTERPRET GEOMETRIC TOLERANCING PER: | Q.A. | Chen Chen & Wuji Zhang

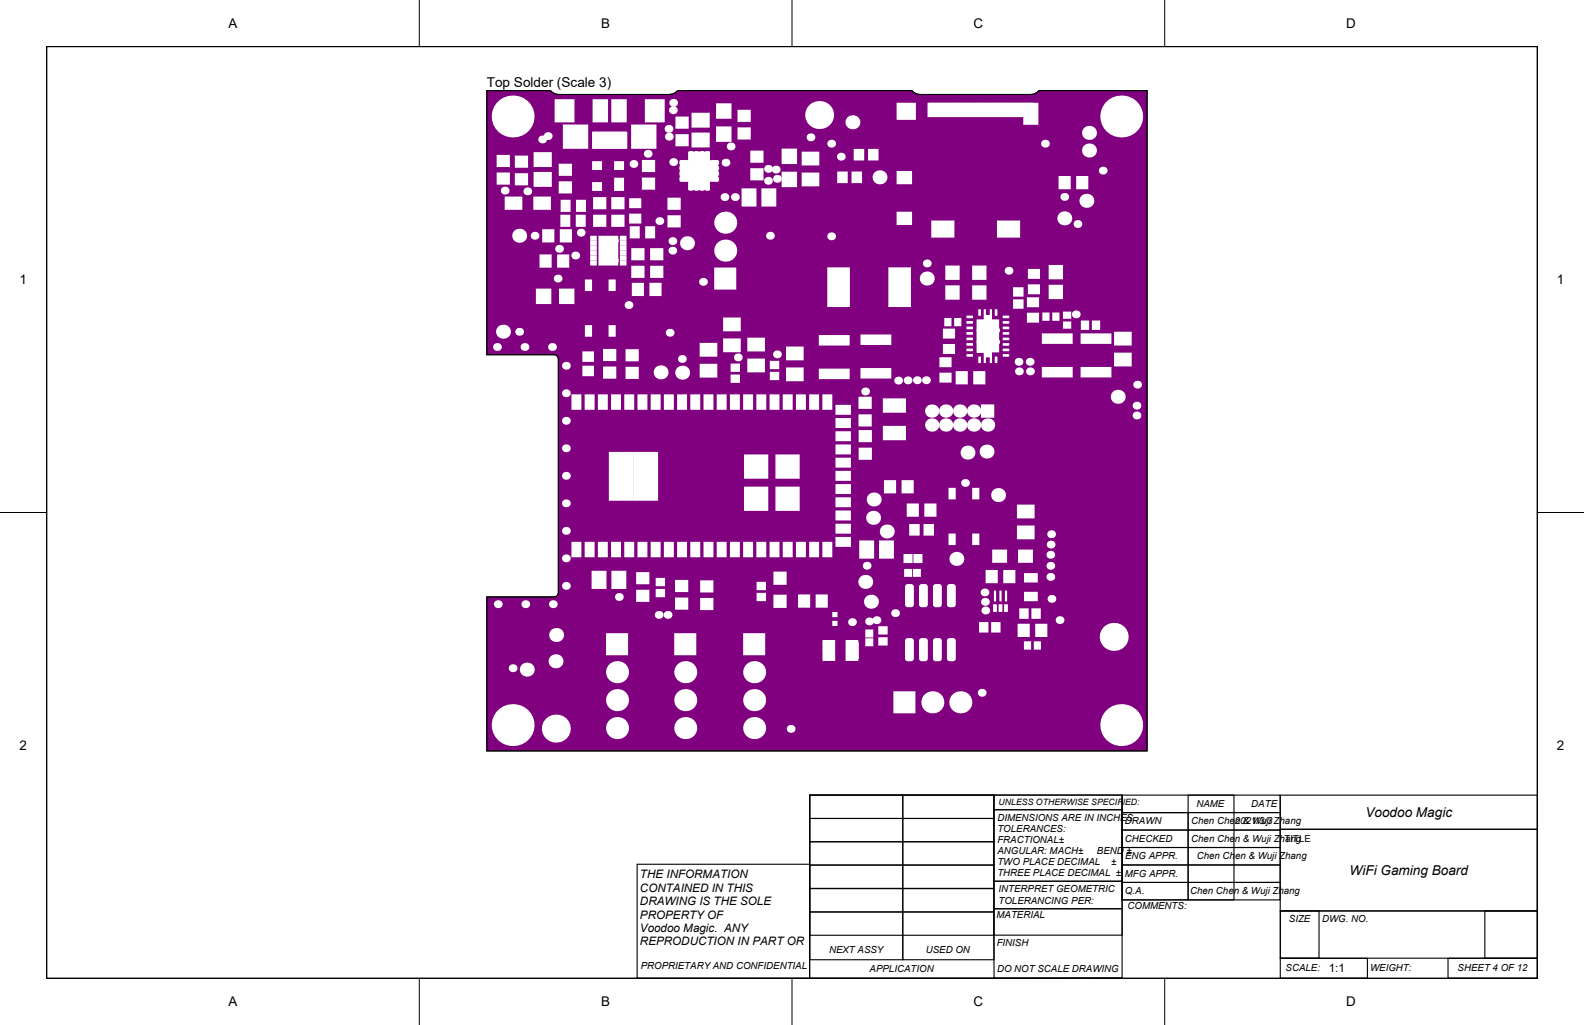
[picture p57: page 13]
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

CHECKED | Chen Chen & Wuji Zhang | | TITLE WiFi Gaming Board
ENG APPR. | Chen Chen & Wuji Zhang

THE INFORMATION CONTAINED IN THIS DRAWING IS THE SOLE PROPERTY OF Voodoo Magic. ANY | | | MFG APPR.

INTERPRET GEOMETRIC TOLERANCING PER: | Q.A. | Chen Chen & Wuji Zhang

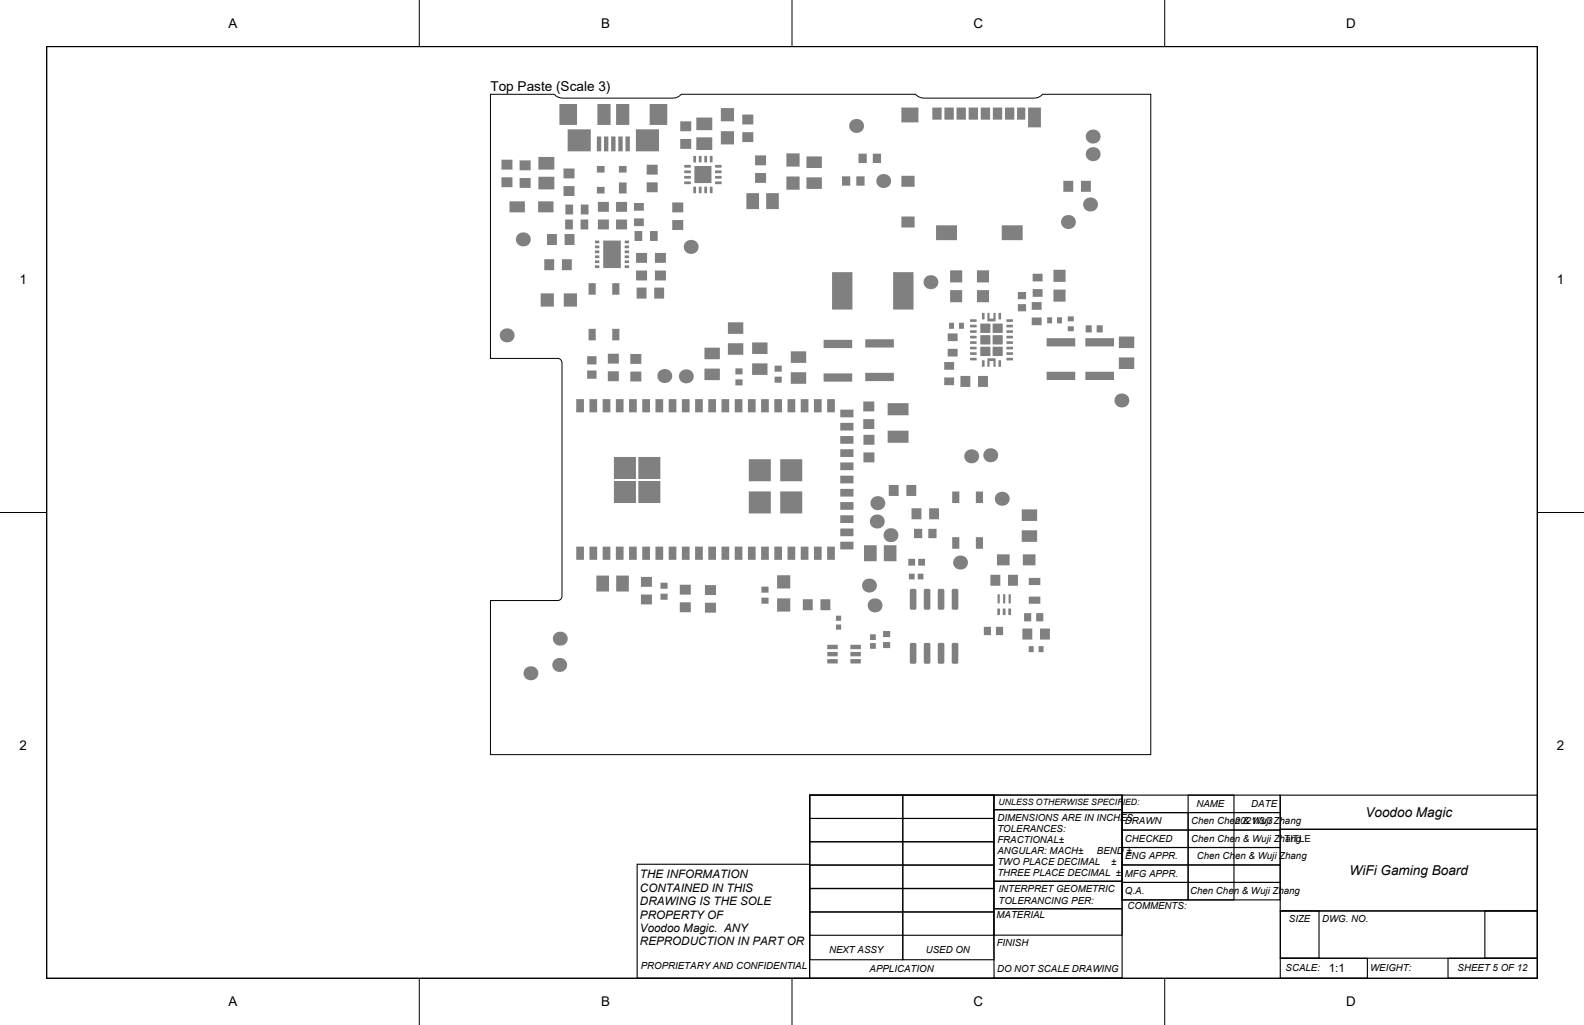
[picture p58: page 14]
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

CHECKED | Chen Chen & Wuji Zhang | | TITLE WiFi Gaming Board
ENG APPR. | Chen Chen & Wuji Zhang

THE INFORMATION CONTAINED IN THIS DRAWING IS THE SOLE PROPERTY OF Voodoo Magic. ANY | | | MFG APPR.

INTERPRET GEOMETRIC TOLERANCING PER: | Q.A. | Chen Chen & Wuji Zhang

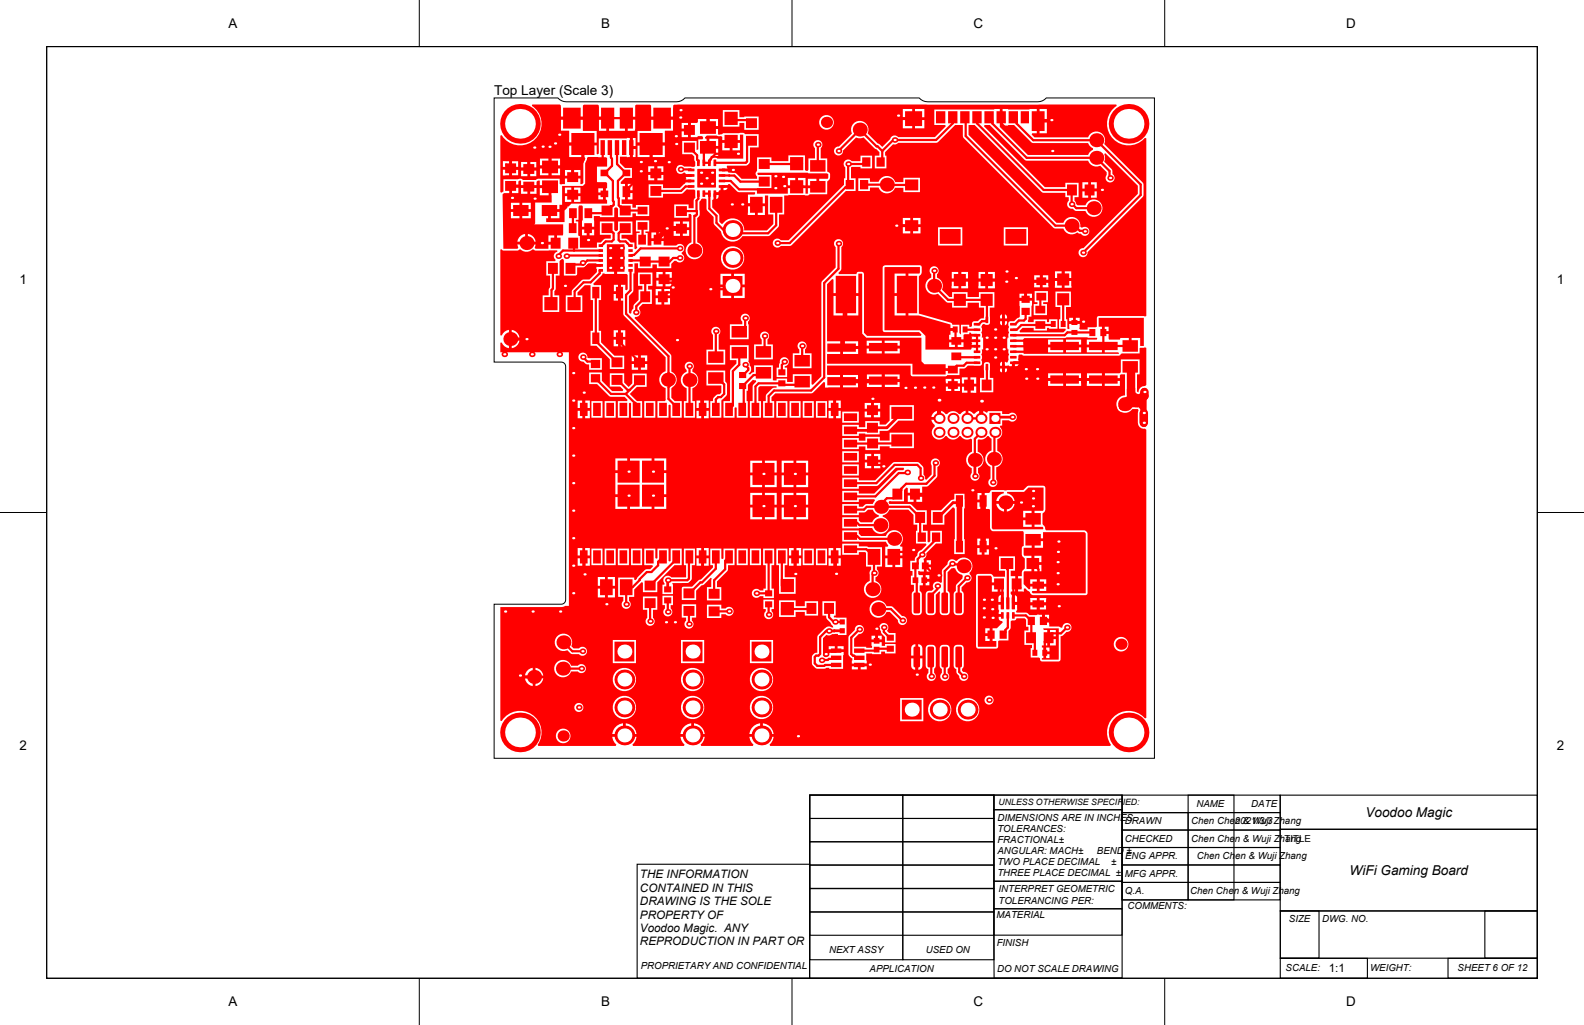
[picture p59: page 15]
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

CHECKED | Chen Chen & Wuji Zhang | | TITLE WiFi Gaming Board
ENG APPR. | Chen Chen & Wuji Zhang

THE INFORMATION CONTAINED IN THIS DRAWING IS THE SOLE PROPERTY OF Voodoo Magic. ANY | | | MFG APPR.

INTERPRET GEOMETRIC TOLERANCING PER: | Q.A. | Chen Chen & Wuji Zhang

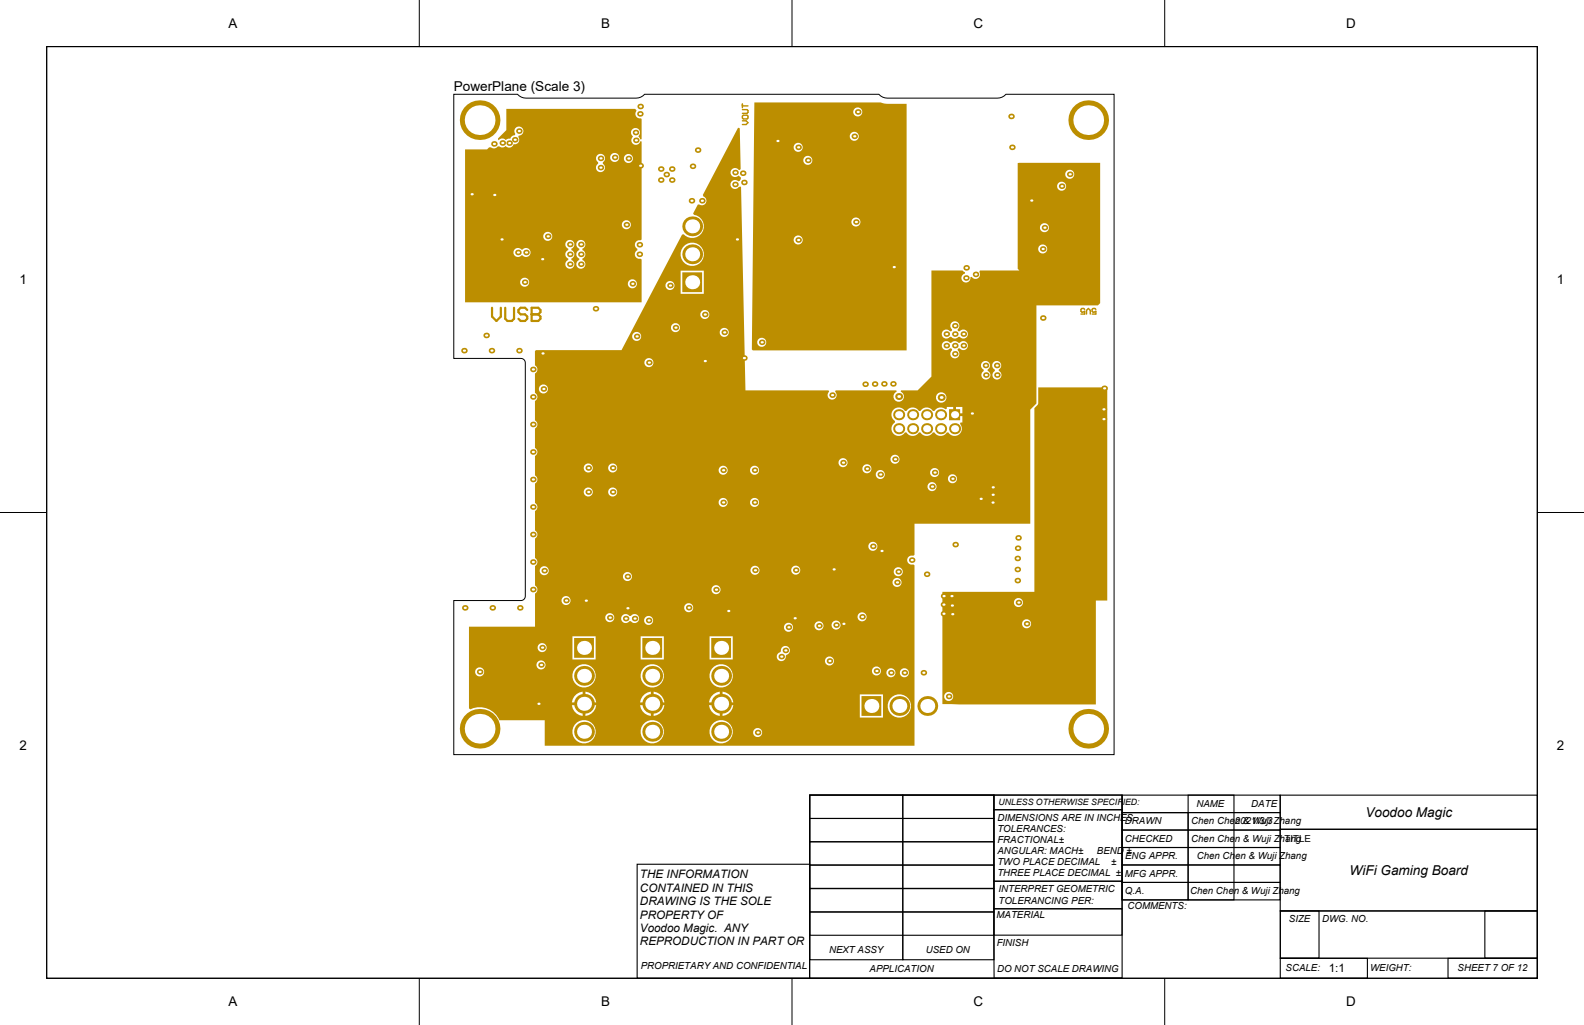
[picture p60: page 16]
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

CHECKED | Chen Chen & Wuji Zhang | | TITLE WiFi Gaming Board
ENG APPR. | Chen Chen & Wuji Zhang

THE INFORMATION CONTAINED IN THIS DRAWING IS THE SOLE PROPERTY OF Voodoo Magic. ANY | | | MFG APPR.

INTERPRET GEOMETRIC TOLERANCING PER: | Q.A. | Chen Chen & Wuji Zhang

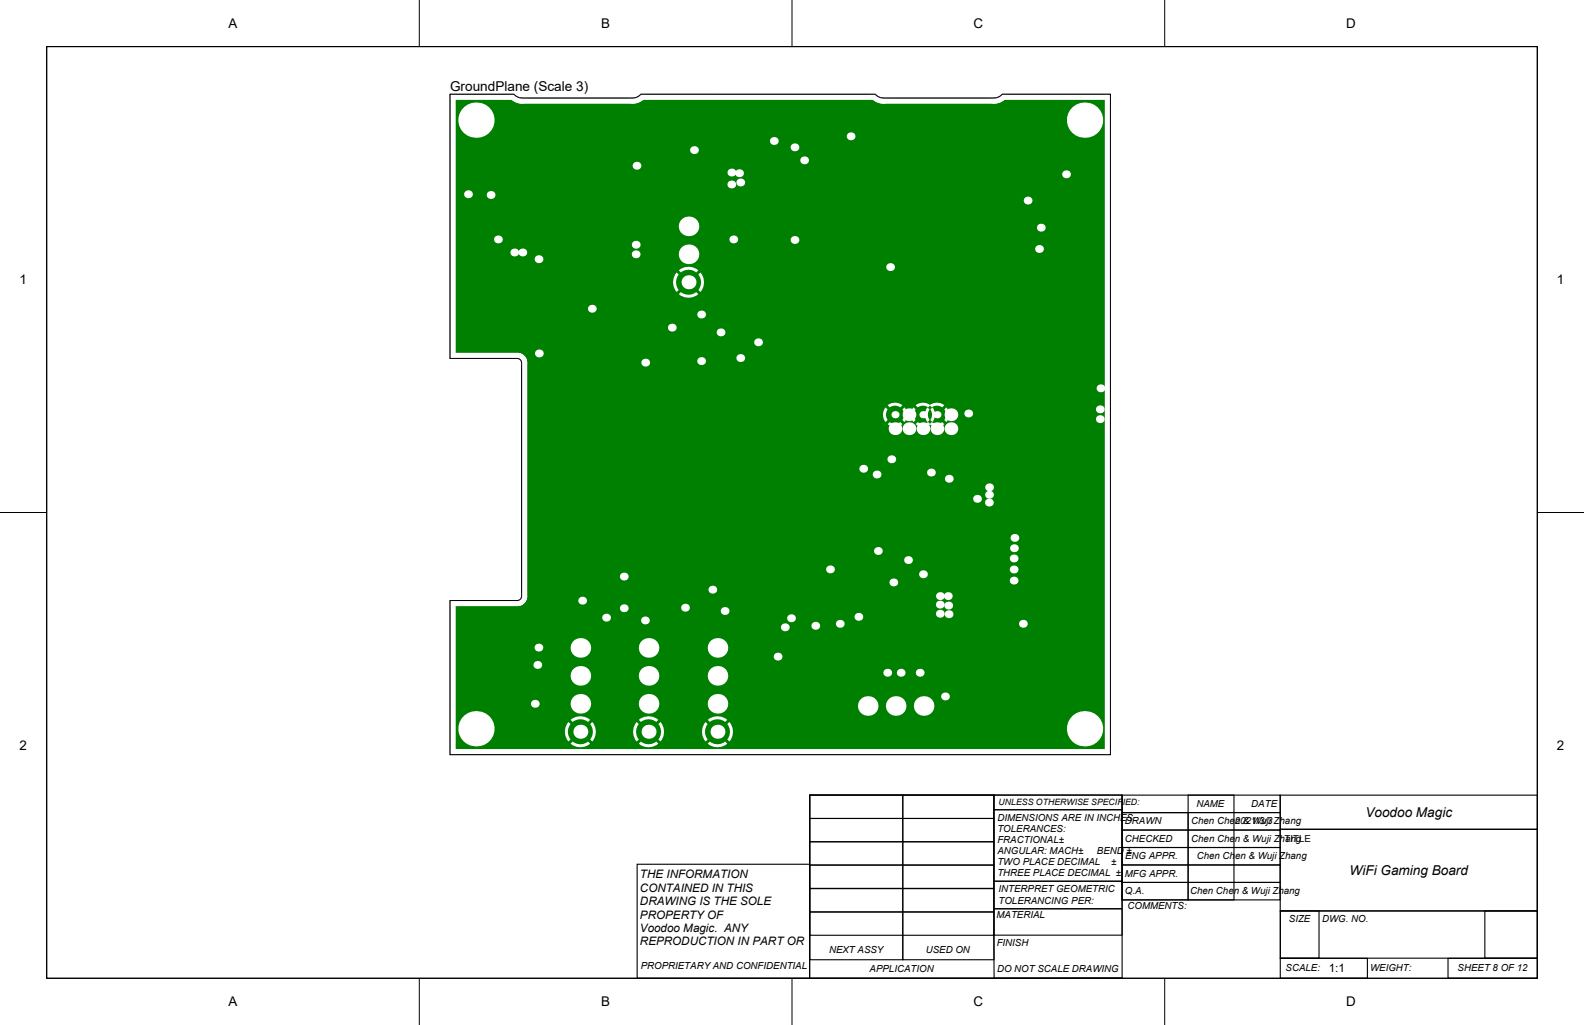
[picture p61: page 17]
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

CHECKED | Chen Chen & Wuji Zhang | | TITLE WiFi Gaming Board
ENG APPR. | Chen Chen & Wuji Zhang

THE INFORMATION CONTAINED IN THIS DRAWING IS THE SOLE PROPERTY OF Voodoo Magic. ANY | | | MFG APPR.

INTERPRET GEOMETRIC TOLERANCING PER: | Q.A. | Chen Chen & Wuji Zhang

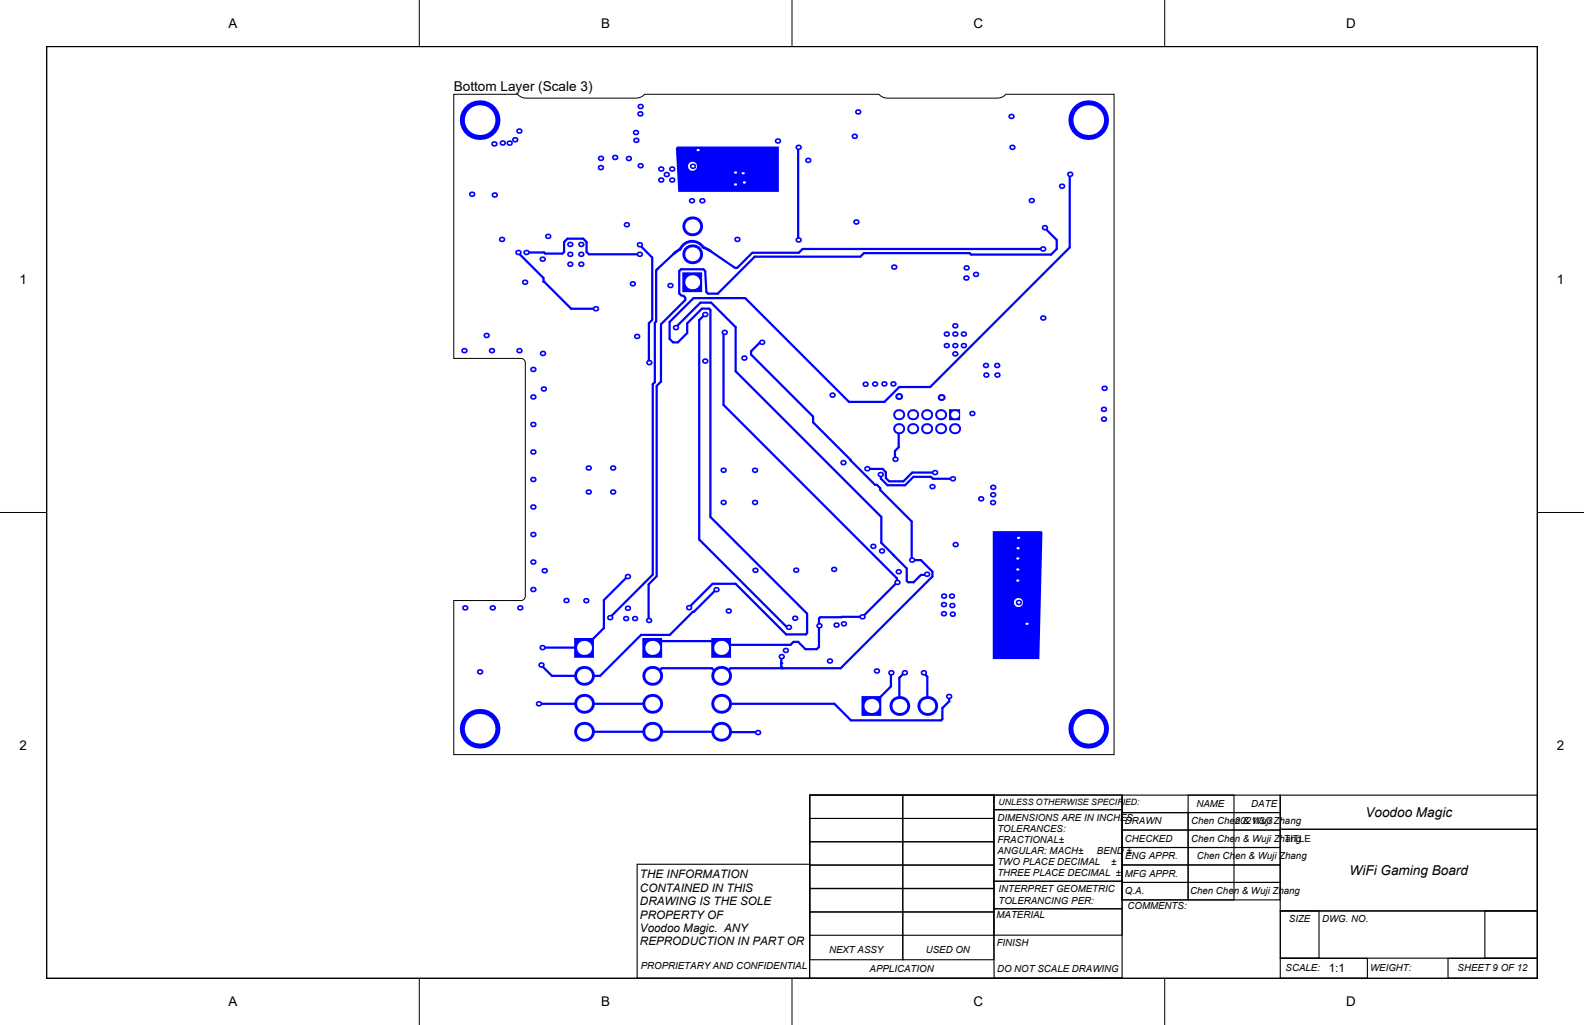
[picture p62: page 18]
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

CHECKED | Chen Chen & Wuji Zhang | | TITLE WiFi Gaming Board
ENG APPR. | Chen Chen & Wuji Zhang

THE INFORMATION CONTAINED IN THIS DRAWING IS THE SOLE PROPERTY OF Voodoo Magic. ANY | | | MFG APPR.

INTERPRET GEOMETRIC TOLERANCING PER: | Q.A. | Chen Chen & Wuji Zhang

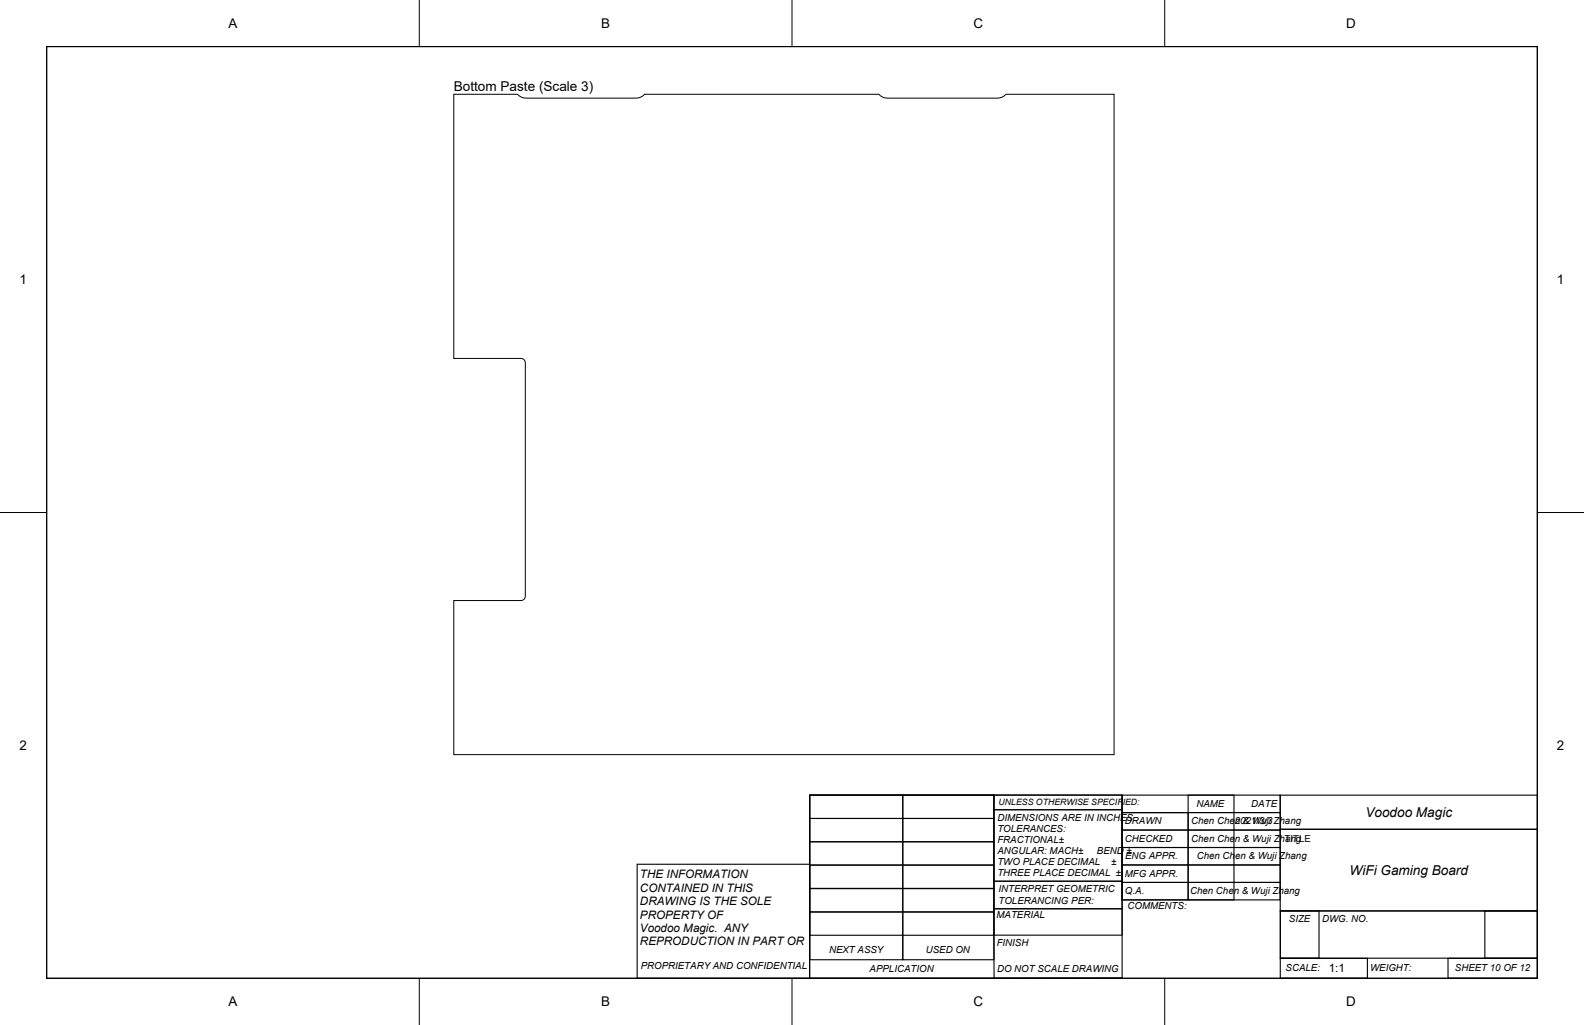
[picture p63: page 19]
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

CHECKED | Chen Chen & Wuji Zhang | | TITLE WiFi Gaming Board
ENG APPR. | Chen Chen & Wuji Zhang

THE INFORMATION CONTAINED IN THIS DRAWING IS THE SOLE PROPERTY OF Voodoo Magic. ANY | | | MFG APPR.

INTERPRET GEOMETRIC TOLERANCING PER: | Q.A. | Chen Chen & Wuji Zhang

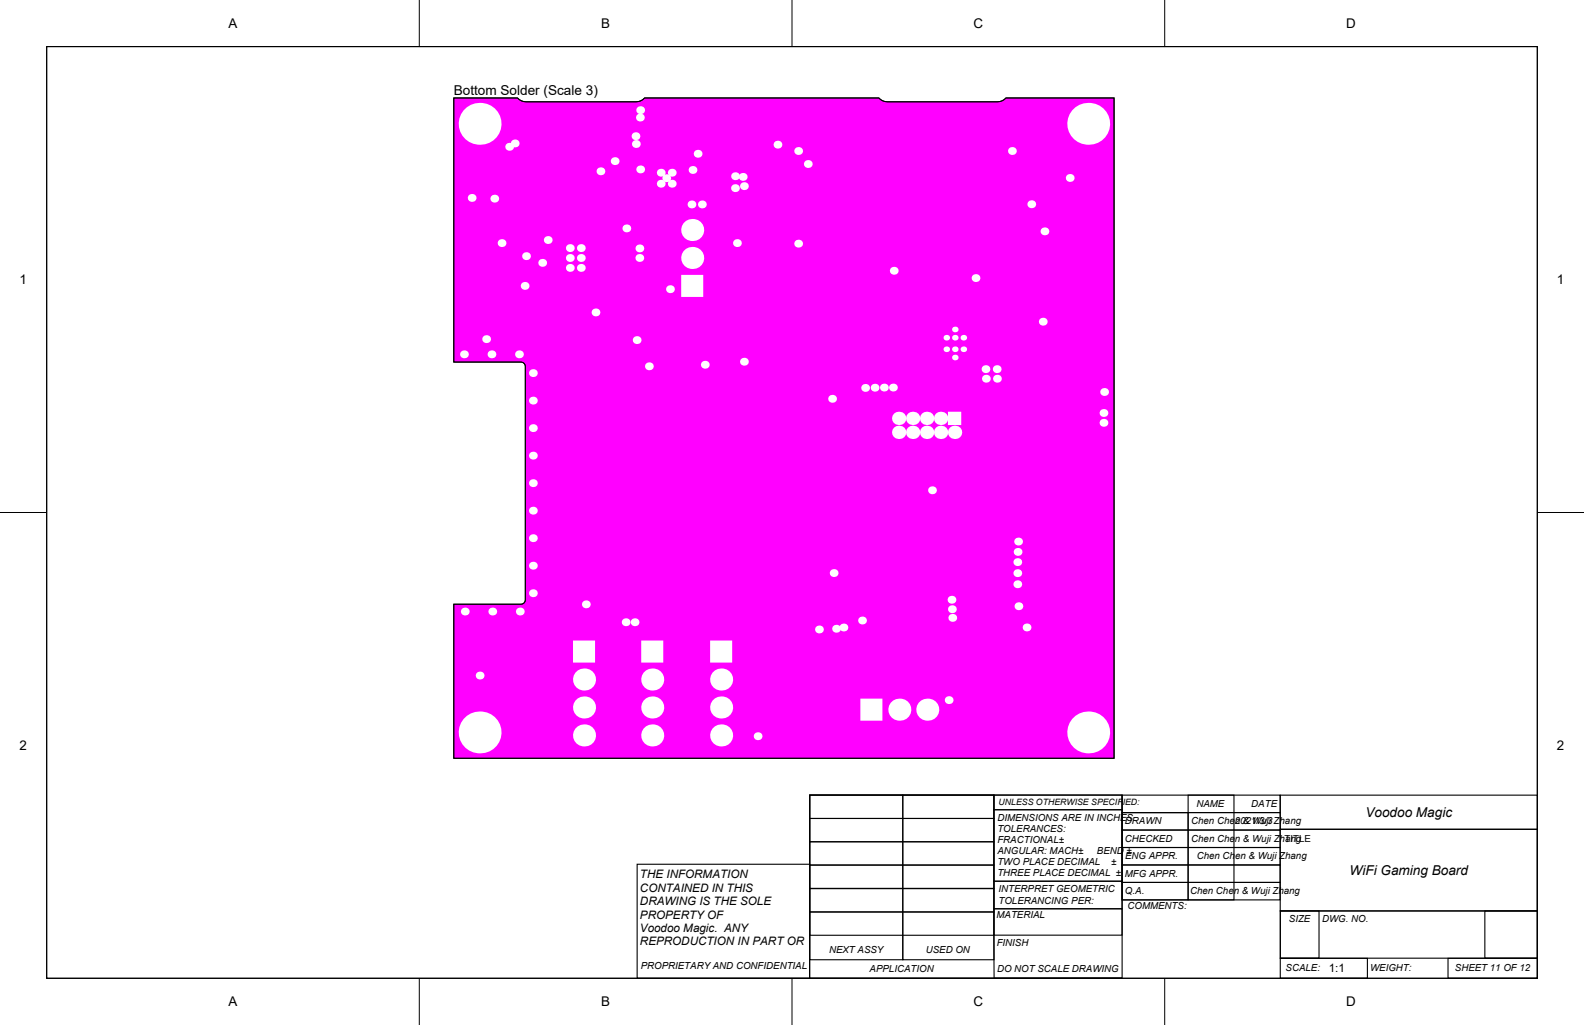
[picture p64: page 20]
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

CHECKED | Chen Chen & Wuji Zhang | | TITLE WiFi Gaming Board
ENG APPR. | Chen Chen & Wuji Zhang

THE INFORMATION CONTAINED IN THIS DRAWING IS THE SOLE PROPERTY OF Voodoo Magic. ANY | | | MFG APPR.

INTERPRET GEOMETRIC TOLERANCING PER: | Q.A. | Chen Chen & Wuji Zhang

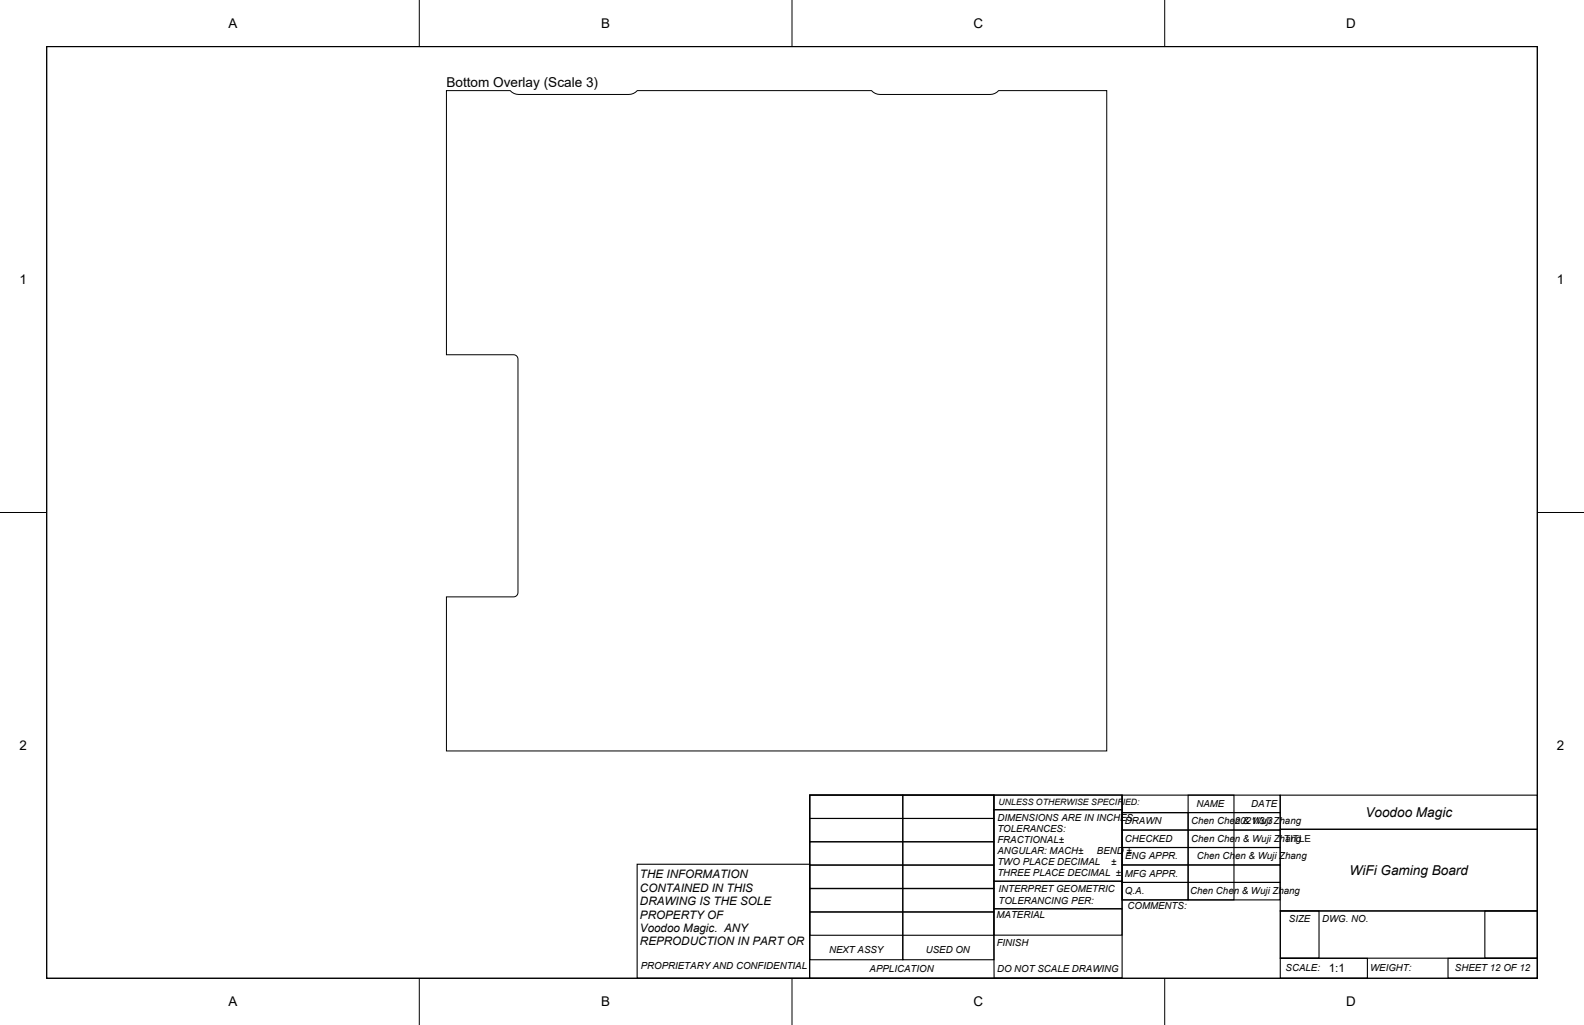
[picture p65: page 21]
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

CHECKED | Chen Chen & Wuji Zhang | | TITLE WiFi Gaming Board
ENG APPR. | Chen Chen & Wuji Zhang

THE INFORMATION CONTAINED IN THIS DRAWING IS THE SOLE PROPERTY OF Voodoo Magic. ANY | | | MFG APPR.

INTERPRET GEOMETRIC TOLERANCING PER: | Q.A. | Chen Chen & Wuji Zhang

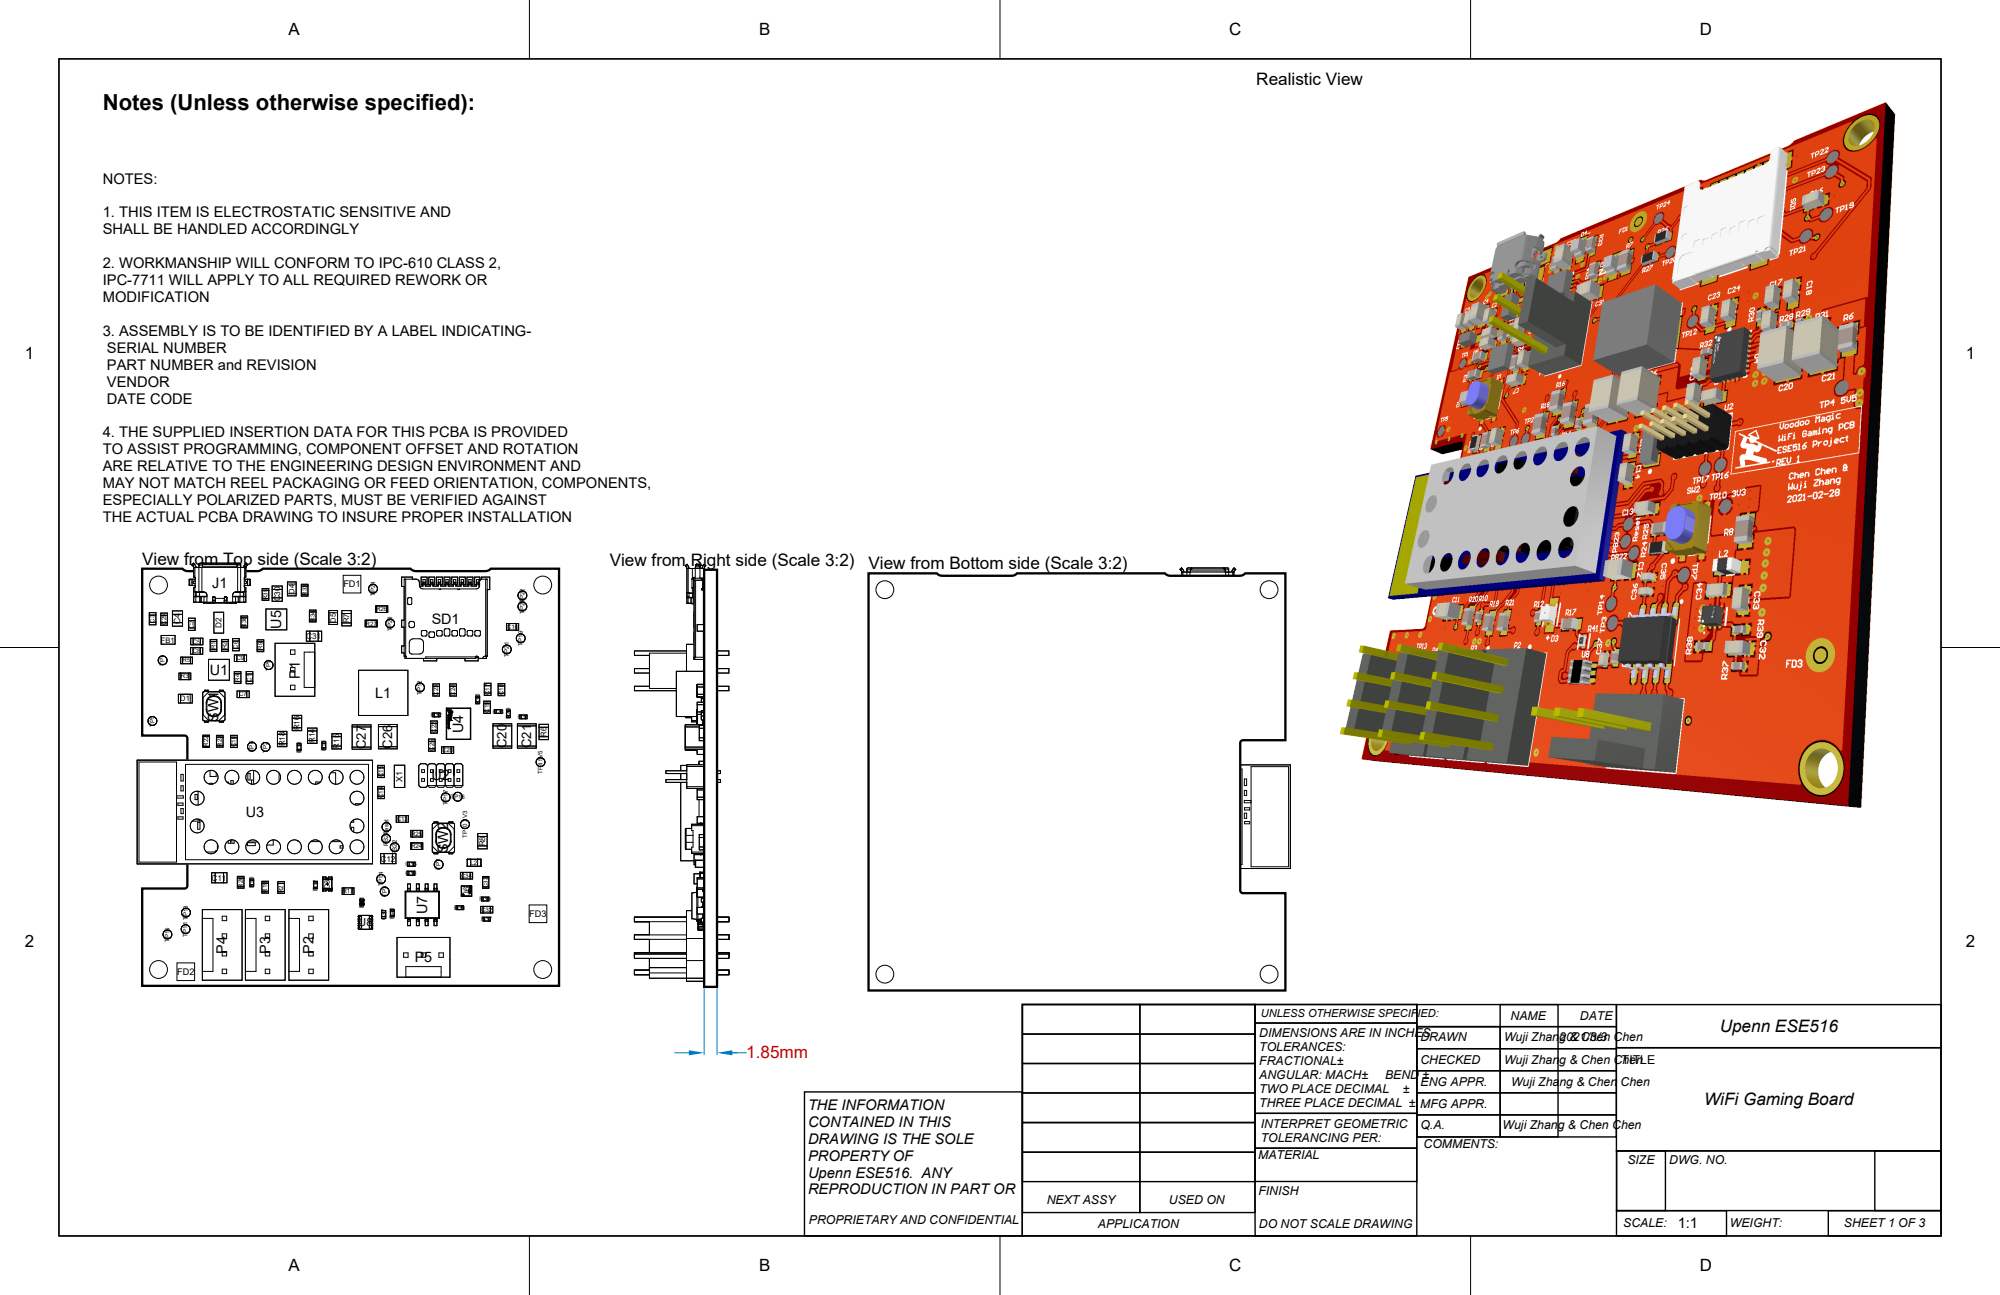
[picture p66: page 22]

Notes (Unless otherwise specified):

1. THIS ITEM IS ELECTROSTATIC SENSITIVE AND
SHALL BE HANDLED ACCORDINGLY

2. WORKMANSHIP WILL CONFORM TO IPC-610 CLASS 2,
IPC-7711 WILL APPLY TO ALL REQUIRED REWORK OR
MODIFICATION

3. ASSEMBLY IS TO BE IDENTIFIED BY A LABEL INDICATING-
SERIAL NUMBER
PART NUMBER and REVISION
VENDOR
DATE CODE

4. THE SUPPLIED INSERTION DATA FOR THIS PCBA IS PROVIDED
TO ASSIST PROGRAMMING, COMPONENT OFFSET AND ROTATION
ARE RELATIVE TO THE ENGINEERING DESIGN ENVIRONMENT AND
MAY NOT MATCH REEL PACKAGING OR FEED ORIENTATION, COMPONENTS,
ESPECIALLY POLARIZED PARTS, MUST BE VERIFIED AGAINST
THE ACTUAL PCBA DRAWING TO INSURE PROPER INSTALLATION

UNLESS OTHERWISE SPECIFIED: | | NAME | DATE | Upenn ESE516
DIMENSIONS ARE IN INCHES TOLERANCES: FRACTIONAL± ANGULAR: MACH± BEND ± TWO PLACE DECIMAL ± THREE PLACE DECIMAL ± | DRAWN | Wuji Zhang & Chen Chen | 2021/3/3

CHECKED | Wuji Zhang & Chen Chen | | TITLE WiFi Gaming Board
ENG APPR. | Wuji Zhang & Chen Chen

THE INFORMATION CONTAINED IN THIS DRAWING IS THE SOLE PROPERTY OF Upenn ESE516. ANY | | | MFG APPR.

INTERPRET GEOMETRIC TOLERANCING PER: | Q.A. | Wuji Zhang & Chen Chen

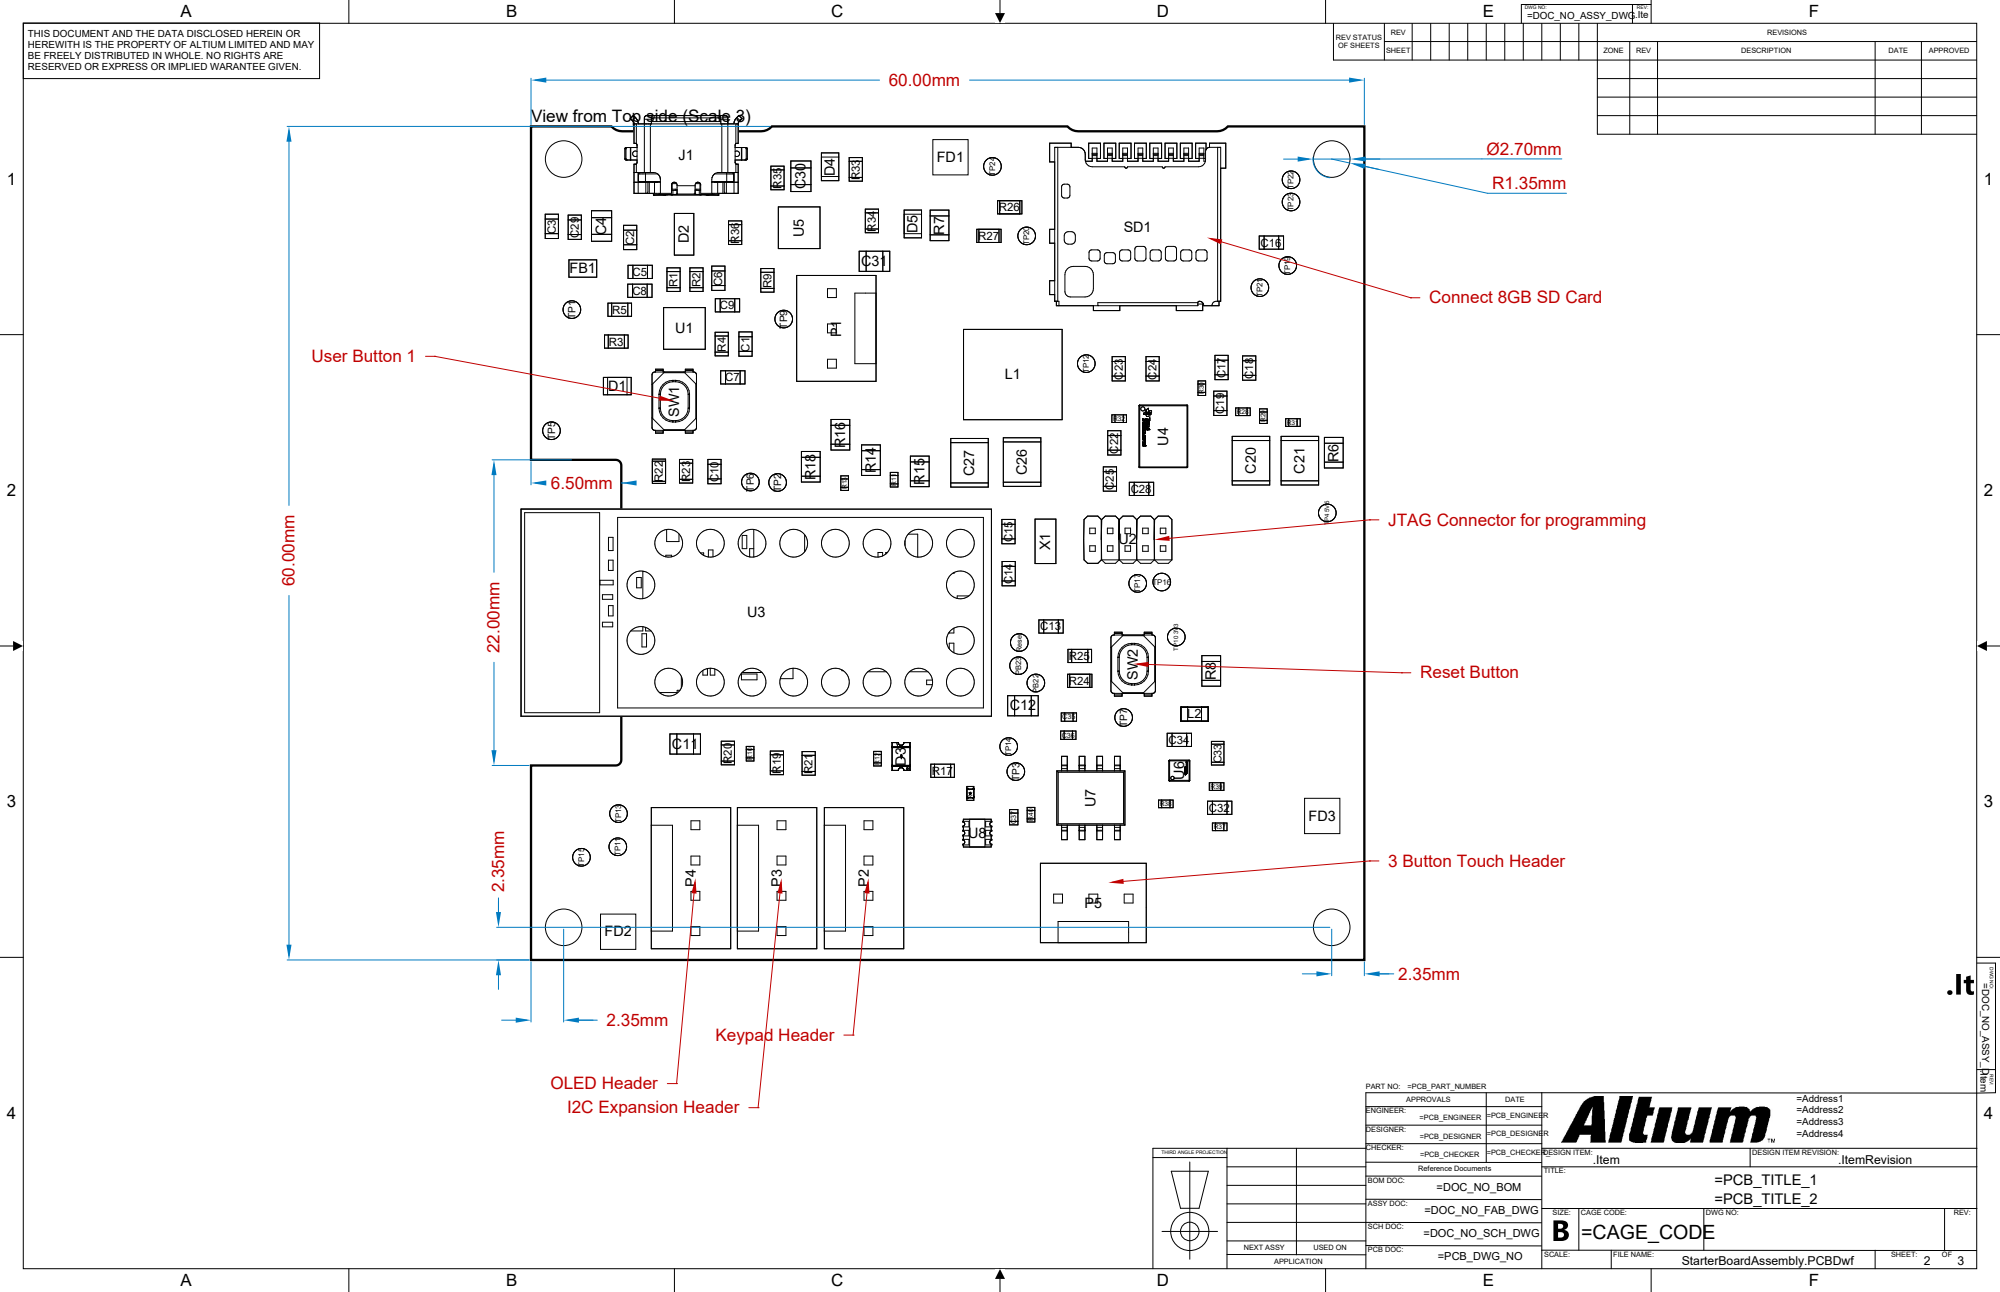
[picture p67: page 23]
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

View from Top side (Scale 3)

JTAG Connector for programming

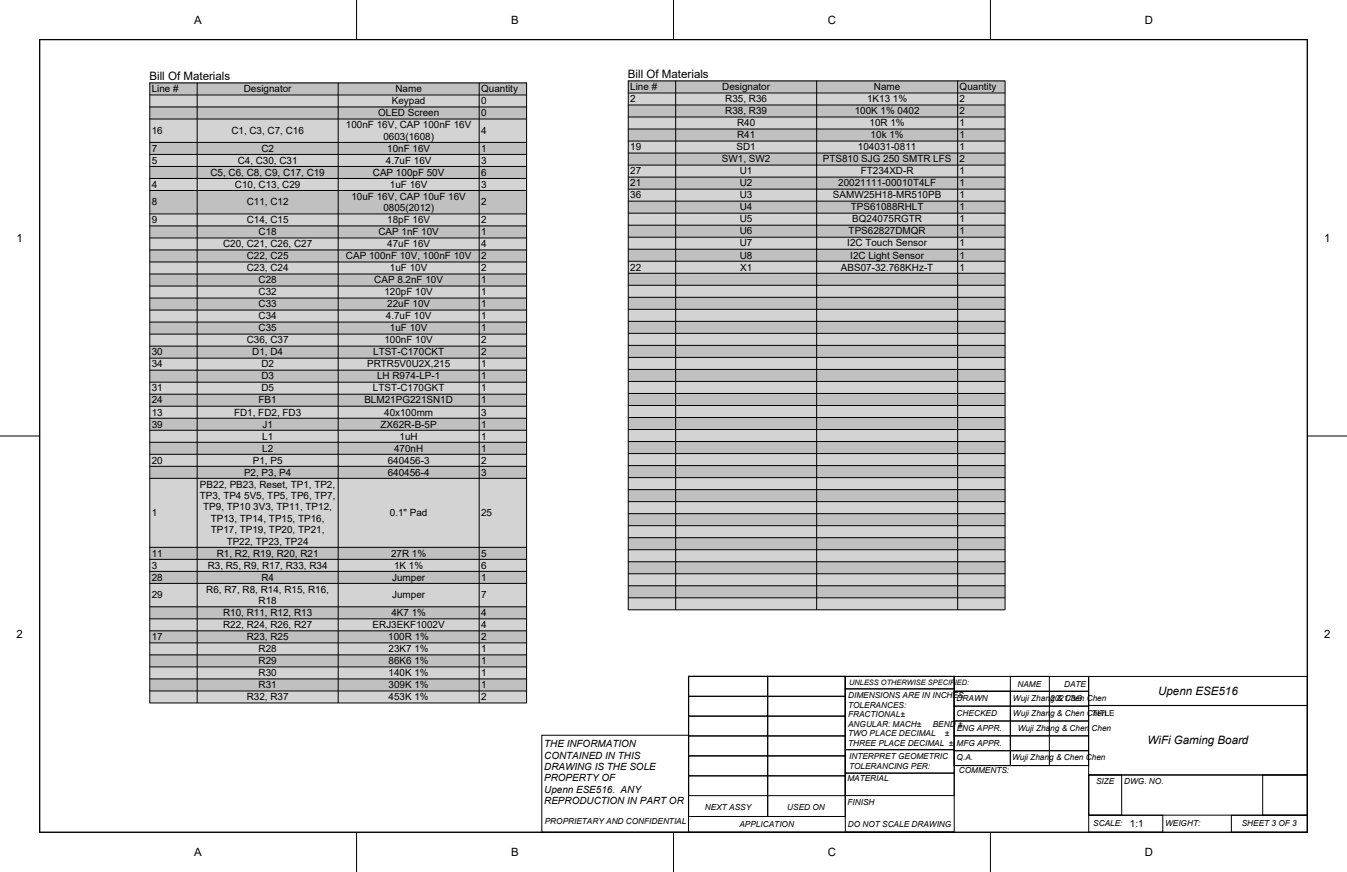
[picture p68: page 24]

C28 | CAP 8.2nF 10V | 1
C32 | 120pF 10V | 1
C33 | 22uF 10V | 1
C34 | 4.7uF 10V | 1
C35 | 1uF 10V | 1
C36, C37 | 100nF 10V | 2

30 | D1, D4 | LTST-C170CKT | 2
34 | D2 | PRTR5V0U2X,215 | 1

31 | D5 | LTST-C170GKT | 1
24 | FB1 | BLM21PG221SN1D | 1
13 | FD1, FD2, FD3 | 40x100mm | 3
39 | J1 | ZX62R-B-5P | 1

L1 | 1uH | 1
L2 | 470nH | 1

1 | PB22, PB23, Reset, TP1, TP2, TP3, TP4 5V5, TP5, TP6, TP7, TP9, TP10 3V3, TP11, TP12, TP13, TP14, TP15, TP16, TP17, TP19, TP20, TP21, TP22, TP23, TP24 | 0.1" Pad | 25

11 | R1, R2, R19, R20, R21 | 27R 1% | 5
3 | R3, R5, R9, R17, R33, R34 | 1K 1% | 6
28 | R4 | Jumper | 1
29 | R6, R7, R8, R14, R15, R16, R18 | Jumper | 7

R10, R11, R12, R13 | 4K7 1% | 4
R22, R24, R26, R27 | ERJ3EKF1002V | 4

R28 | 23K7 1% | 1
R29 | 86K6 1% | 1
R30 | 140K 1% | 1
R31 | 309K 1% | 1

UNLESS OTHERWISE SPECIFIED: | NAME | DATE | Upenn ESE516

DIMENSIONS ARE IN INCHES
TOLERANCES:
FRACTIONAL±
TWO PLACE DECIMAL ±
THREE PLACE DECIMAL ±

CHECKED | Wuji Zhang & Chen Chen | TITLE WiFi Gaming Board
ENG APPR. | Wuji Zhang & Chen Chen

THE INFORMATION CONTAINED IN THIS DRAWING IS THE SOLE PROPERTY OF Upenn ESE516. ANY | | | MFG APPR.

INTERPRET GEOMETRIC TOLERANCING PER: | Q.A. | Wuji Zhang & Chen Chen
