Kenny-Z/ESE516Group/(list of files, drawings)

Other design files:
AltuimProject/VoodooMagic/5V5_BOOST.SchDoc
AltuimProject/VoodooMagic/5V5to3V3Buck.SchDoc
AltuimProject/VoodooMagic/FTDI.SchDoc
AltuimProject/VoodooMagic/LiPo_Charger.SchDoc
AltuimProject/VoodooMagic/MAIN.SchDoc
AltuimProject/VoodooMagic/MCU.SchDoc
AltuimProject/VoodooMagic/Memory.SchDoc
AltuimProject/VoodooMagic/Sensors.SchDoc
AltuimProject/VoodooMagic/VoodooMagic.PrjPcb
