Kenny-Z/ESE516Group/AtmelProject/WINC1500_HTTP_DOWNLOADER_EXAMPLE1/src/main.c

/**************************************************************************/ /**
* @file      main.c
* @brief     Main application entry point
* @author    Eduardo Garcia
* @date      2020-02-15
* @copyright Copyright Bresslergroup\n
*            This file is proprietary to Bresslergroup.
*            All rights reserved. Reproduction or distribution, in whole
*            or in part, is forbidden except by express written permission
*            of Bresslergroup.
******************************************************************************/


/******************************************************************************
* Includes
******************************************************************************/
#include <errno.h>
#include "asf.h"
#include "main.h"
#include "stdio_serial.h"
#include "SerialConsole.h"
#include "FreeRTOS.h"
#include "driver/include/m2m_wifi.h"
#include "SeesawDriver/Seesaw.h"
#include "OLED_driver/OLED_driver.h"

//Threads
#include "FreeRTOS_Threads/CliThread/CliThread.h"
#include "FreeRTOS_Threads/LightThread/LightThread.h"
#include "FreeRTOS_Threads/WifiHandlerThread/WifiHandler.h"
#include "FreeRTOS_Threads/UiHandlerThread/UiHandlerThread.h"
#include "FreeRTOS_Threads/ControlThread/ControlThread.h"

/******************************************************************************
* Defines and Types
******************************************************************************/
#define APP_TASK_ID 0 /**< @brief ID for the application task */
#define CLI_TASK_ID 1 /**< @brief ID for the command line interface task */
//#define BOOT_TEST	1 //Uncomment me to compile boot test.

/******************************************************************************
* Local Function Declaration
******************************************************************************/
void vApplicationIdleHook(void);
//!< Initial task used to initialize HW before other tasks are initialized
static void StartTasks(void);
void vApplicationDaemonTaskStartupHook(void);
static void TestB(void);
static void TestA(void);
/******************************************************************************
* Variables
******************************************************************************/
static TaskHandle_t cliTaskHandle    = NULL; //!< CLI task handle
static TaskHandle_t daemonTaskHandle    = NULL; //!< Daemon task handle
static TaskHandle_t wifiTaskHandle    = NULL; //!< Wifi task handle
static TaskHandle_t uiTaskHandle    = NULL; //!< UI task handle
static TaskHandle_t controlTaskHandle    = NULL; //!< Control task handle
static TaskHandle_t lightTaskHandle    = NULL; //!< Control task handle

char bufferPrint[64]; //Buffer for daemon task

/**
 * \brief Main application function.
 *
 * Application entry point.
 *
 * \return program return value.
 */
int main(void)
{
	/* Initialize the board. */
	system_init();

	/* Initialize the UART console. */
	InitializeSerialConsole();

	//Initialize trace capabilities
	 vTraceEnable(TRC_START);
    // Start FreeRTOS scheduler
    vTaskStartScheduler();

	return 0; //Will not get here
}

/**************************************************************************/ /**
* function          vApplicationDaemonTaskStartupHook
* @brief            Initialization code for all subsystems that require FreeRToS
* @details			This function is called from the FreeRToS timer task. Any code
*					here will be called before other tasks are initilized.
* @param[in]        None
* @return           None
*****************************************************************************/
void vApplicationDaemonTaskStartupHook(void)
{
	SerialConsoleWriteString("\r\n\r\n-----ESE516 Main Program-----\r\n");

	//Initialize HW that needs FreeRTOS Initialization
	SerialConsoleWriteString("\r\n\r\nInitialize HW...\r\n");
	if (I2cInitializeDriver() != STATUS_OK)
	{
		SerialConsoleWriteString("Error initializing I2C Driver!\r\n");
	}
	else
	{
		SerialConsoleWriteString("Initialized I2C Driver!\r\n");
	}

	if(0 != InitializeSeesaw())
	{
		SerialConsoleWriteString("Error initializing Seesaw!\r\n");
	}	
	else
	{
		SerialConsoleWriteString("Initialized Seesaw!\r\n");
	}
	
	//initialize OLED
	if (InitializeOLEDdriver() != STATUS_OK)
	{
		SerialConsoleWriteString("Error initializing OLED Driver!\r\n");
	}
	else
	{
		SerialConsoleWriteString("Initialized OLED Driver!\r\n");
	}

	StartTasks();

	vTaskSuspend(daemonTaskHandle);
}

/**************************************************************************//**
* function          StartTasks
* @brief            Initialize application tasks
* @details
* @param[in]        None
* @return           None
*****************************************************************************/
static void StartTasks(void)
{

	snprintf(bufferPrint, 64, "Heap before starting tasks: %d\r\n", xPortGetFreeHeapSize());
	SerialConsoleWriteString(bufferPrint);

	//Initialize Tasks here

	if (xTaskCreate(vCommandConsoleTask, "CLI_TASK", CLI_TASK_SIZE, NULL, CLI_PRIORITY, &cliTaskHandle) != pdPASS) {
		SerialConsoleWriteString("ERR: CLI task could not be initialized!\r\n");
	}

	snprintf(bufferPrint, 64, "Heap after starting CLI: %d\r\n", xPortGetFreeHeapSize());
	SerialConsoleWriteString(bufferPrint);


	if (xTaskCreate(vWifiTask, "WIFI_TASK", WIFI_TASK_SIZE, NULL, WIFI_PRIORITY, &wifiTaskHandle) != pdPASS) {
		SerialConsoleWriteString("ERR: WIFI task could not be initialized!\r\n");
	}
	snprintf(bufferPrint, 64, "Heap after starting WIFI: %d\r\n", xPortGetFreeHeapSize());
	SerialConsoleWriteString(bufferPrint);


	if(xTaskCreate(vUiHandlerTask, "UI Task", UI_TASK_SIZE, NULL, UI_TASK_PRIORITY, &uiTaskHandle) != pdPASS) {
		SerialConsoleWriteString("ERR: UI task could not be initialized!\r\n");
	}

	snprintf(bufferPrint, 64, "Heap after starting UI Task: %d\r\n", xPortGetFreeHeapSize());
	SerialConsoleWriteString(bufferPrint);

	if(xTaskCreate(vControlHandlerTask, "Control Task", CONTROL_TASK_SIZE, NULL, CONTROL_TASK_PRIORITY, &controlTaskHandle) != pdPASS) {
		SerialConsoleWriteString("ERR: Control task could not be initialized!\r\n");
	}
	snprintf(bufferPrint, 64, "Heap after starting Control Task: %d\r\n", xPortGetFreeHeapSize());
	SerialConsoleWriteString(bufferPrint);

	if(xTaskCreate(vLightReadTask, "Light Task", LIGHT_TASK_SIZE, NULL, LIGHTSENSOR_PRIORITY, &lightTaskHandle) != pdPASS) {
		SerialConsoleWriteString("ERR: Light task could not be initialized!\r\n");
	}
	snprintf(bufferPrint, 64, "Heap after starting Light Task: %d\r\n", xPortGetFreeHeapSize());
	SerialConsoleWriteString(bufferPrint);
}

static void configure_console(void)
{

	stdio_base = (void *)GetUsartModule();
	ptr_put = (int (*)(void volatile*,char))&usart_serial_putchar;
	ptr_get = (void (*)(void volatile*,char*))&usart_serial_getchar;


	# if defined(__GNUC__)
	// Specify that stdout and stdin should not be buffered.
	setbuf(stdout, NULL);
	setbuf(stdin, NULL);
	// Note: Already the case in IAR's Normal DLIB default configuration
	// and AVR GCC library:
	// - printf() emits one character at a time.
	// - getchar() requests only 1 byte to exit.
	#  endif
	//stdio_serial_init(GetUsartModule(), EDBG_CDC_MODULE, &usart_conf);
	//usart_enable(&cdc_uart_module);
}

void vApplicationMallocFailedHook(void)
{
	SerialConsoleWriteString("Error on memory allocation on FREERTOS!\r\n");
	while(1);
}

void vApplicationStackOverflowHook(void)
{
	SerialConsoleWriteString("Error on stack overflow on FREERTOS!\r\n");
	while(1);
}

#include "MCHP_ATWx.h"
void vApplicationTickHook (void)
{
	SysTick_Handler_MQTT();
}
