Kenny-Z/ESE516Group/AtmelProject/WINC1500_HTTP_DOWNLOADER_EXAMPLE1/src/OLED_Driver/OLED_driver.c

/**************************************************************************//**
* @file      OLED_driver.c
* @brief     Driver for the OLED from Sparkfun. See https://github.com/sparkfun/SparkFun_Micro_OLED_Arduino_Library/blob/master/src/SFE_MicroOLED.cpp

* @author    Chen Chen
* @date      2021-04-16

******************************************************************************/

#include "OLED_driver.h"
#include "I2cDriver/I2cDriver.h"
#include "SerialConsole.h"
/******************************************************************************
* Includes
******************************************************************************/
#include "OLED_driver/util/font5x7.h"				// Font 0
#include "OLED_driver/util/font8x16.h"				// Font 1
#include "OLED_driver/util/7segment.h"				// Font 2
#include "OLED_driver/util/fontlargenumber.h"		// Font 3
#include "OLED_driver/util/fontlargeletter31x48.h"	// Font 4 (excluded by default - see below)

/******************************************************************************
* Defines
******************************************************************************/
#ifndef _BV
#define _BV(x) (1 << x)
#endif
#define MAXFONTS 5 // Do not change this line - except when _adding_ new fonts

#define i2cTransactionSize 32

#ifndef INCLUDE_FONT_5x7
#define INCLUDE_FONT_5x7 1			// Change this to 0 to exclude the 5x7 font
#endif
#ifndef INCLUDE_FONT_8x16
#define INCLUDE_FONT_8x16 1			// Change this to 0 to exclude the 8x16 font
#endif
#ifndef INCLUDE_FONT_7SEG
#define INCLUDE_FONT_7SEG 1			// Change this to 0 to exclude the seven segment font
#endif
#ifndef INCLUDE_FONT_LARGENUMBER
#define INCLUDE_FONT_LARGENUMBER 1	// Change this to 0 to exclude the large number font
#endif
#ifndef INCLUDE_FONT_LARGELETTER
#define INCLUDE_FONT_LARGELETTER 0	// Change this to 1 to include the large letter font
#endif
/******************************************************************************
* Variables
******************************************************************************/
I2C_Data OLEDData; ///<Global variable to use for I2C communications with the Seesaw Device
/******************************************************************************
* Forward Declarations
******************************************************************************/

/******************************************************************************
* @brief	MicroOLED screen buffer.
* 
* @details	Page buffer 64 x 48 divided by 8 = 384 bytes
*			Page buffer is required because in SPI mode, the host cannot read the SSD1306's GDRAM of the controller.  
*			This page buffer serves as a scratch RAM for graphical functions.  
*			All drawing function will first be drawn on this page buffer, 
*			only upon calling display() function will transfer the page buffer to the actual LCD controller's memory.
******************************************************************************/
static uint8_t screenmemory[] = {
	/* LCD Memory organised in 64 horizontal pixel and 6 rows of byte
	 B  B .............B  -----
	 y  y .............y        \
	 t  t .............t         \
	 e  e .............e          \
	 0  1 .............63          \
	                                \
	 D0 D0.............D0            \
	 D1 D1.............D1            / ROW 0
	 D2 D2.............D2           /
	 D3 D3.............D3          /
	 D4 D4.............D4         /
	 D5 D5.............D5        /
	 D6 D6.............D6       /
	 D7 D7.............D7  ----
	*/
	//SparkFun Electronics LOGO

	// ROW0, BYTE0 to BYTE63
	0x00, 0x00, 0x00, 0x00, 0x00, 0x00, 0x00, 0x00, 0x00, 0x00, 0x00, 0x00, 0x00, 0x00, 0x00, 0x00,
	0x00, 0x00, 0x00, 0x00, 0x00, 0x00, 0x00, 0x00, 0x00, 0x00, 0x00, 0x00, 0x00, 0x00, 0x00, 0x00,
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
	fontlargenumber,
	#else
	NULL,
	#endif
	#if INCLUDE_FONT_LARGELETTER
	fontlargeletter31x48
	#else
	NULL
	#endif
};
/******************************************************************************
* Callback Functions
******************************************************************************/


/******************************************************************************
* Functions
******************************************************************************/

/*****************************************************************************
* @fn		int InitializeOLEDdriver(void)
* @brief	Initializes the OLED driver
* @details 	Assumes I2C is already initialized
                				
* @return		Returns 0 if no errors.
* @note         
*****************************************************************************/
int InitializeOLEDdriver(void)
{
	// default 5x7 font
	MicroOLEDsetFontType(0);
	MicroOLEDsetColor(WHITE);
	MicroOLEDsetDrawMode(NORM);
	MicroOLEDsetCursor(0, 0);

	// Display Init sequence for 64x48 OLED module
	int error = MicroOLEDcommand(DISPLAYOFF); // 0xAE
	if(ERROR_NONE != error)
	{
		SerialConsoleWriteString("Error initializing OLED!\r\n");
	}
	else
	{
		SerialConsoleWriteString("OLED Turned off!\r\n");
	}

	error = MicroOLEDcommand(SETDISPLAYCLOCKDIV); // 0xD5
	if(ERROR_NONE != error)
	{
		SerialConsoleWriteString("Error initializing OLED clock!\r\n");
	}
	else
	{
		SerialConsoleWriteString("OLED clock set!\r\n");
	}
	MicroOLEDcommand(0x80);				 // the suggested ratio 0x80

	MicroOLEDcommand(SETMULTIPLEX); // 0xA8
	MicroOLEDcommand(0x2F);

	MicroOLEDcommand(SETDISPLAYOFFSET); // 0xD3
	MicroOLEDcommand(0x0);			   // no offset

	MicroOLEDcommand(SETSTARTLINE | 0x0); // line #0

	MicroOLEDcommand(CHARGEPUMP); // enable charge pump
	MicroOLEDcommand(0x14);

	MicroOLEDcommand(NORMALDISPLAY);		 // 0xA6
	MicroOLEDcommand(DISPLAYALLONRESUME); // 0xA4

	MicroOLEDcommand(SEGREMAP | 0x1);
	MicroOLEDcommand(COMSCANDEC);

	MicroOLEDcommand(SETCOMPINS); // 0xDA
	MicroOLEDcommand(0x12);

	MicroOLEDcommand(SETCONTRAST); // 0x81
	MicroOLEDcommand(0x8F);

	MicroOLEDcommand(SETPRECHARGE); // 0xd9
	MicroOLEDcommand(0xF1);

	MicroOLEDcommand(SETVCOMDESELECT); // 0xDB
	MicroOLEDcommand(0x40);

	MicroOLEDcommand(DISPLAYON); //--turn on oled panel
	error = MicroOLEDclear(!ALL);			// Erase hardware memory inside the OLED controller to avoid random data in memory.
	return error;
}
/*****************************************************************************
* @fn
/** \brief Send the display a command byte
    Send a command via I2C 	to SSD1306 controller.
	For I2C  we use the write functions
	defined in hardware.cpp to send the data.
* @brief	Initializes the OLED driver
* @details 	Assumes I2C is already initialized

* @return		Returns 0 if no errors.
* @note
*****************************************************************************/

int MicroOLEDcommand(uint8_t c)
{
	// Write to our address, make sure it knows we're sending a
	// command:
	uint8_t msg[2]={I2C_COMMAND,c};
	OLEDData.address = OLED_I2C_ADDRESS_SA0_1;
	OLEDData.msgOut = &msg;
	OLEDData.lenOut = sizeof(msg);
	OLEDData.lenIn = 0;
	int error = I2cWriteDataWait(&OLEDData, 100);
	return error;

}

/*****************************************************************************
* @fn
/** \brief Send the display a data byte
    Send a data byte via SPI, I2C or parallel to SSD1306 controller.
	For SPI we set the DC and CS pins here, and call spiTransfer(byte)
	to send the data. For I2C and Parallel we use the write functions
	defined in hardware.cpp to send the data.
* @brief	Initializes the OLED driver
* @details 	Assumes I2C is already initialized

* @return		Returns 0 if no errors.
* @note
*****************************************************************************/
int MicroOLEDdata(uint8_t c)
{
	uint8_t msg[2]={I2C_DATA,c};
	OLEDData.address = OLED_I2C_ADDRESS_SA0_1;
	OLEDData.msgOut = &msg;
	OLEDData.lenOut = sizeof(msg);
	OLEDData.lenIn = 0;
	int error = I2cWriteDataWait(&OLEDData, 100);
	return error;
	
}

/*****************************************************************************
* @fn
/** \brief Clear screen buffer or SSD1306's memory.
    To clear GDRAM inside the LCD controller, pass in the variable mode = ALL and to clear screen page buffer pass in the variable mode = PAGE.
* @brief	Initializes the OLED driver
* @details 	Assumes I2C is already initialized

* @return		Returns 0 if no errors.
* @note
*****************************************************************************/
int MicroOLEDclear(uint8_t mode)
{
int error = NULL;
	if (mode == ALL)
	{
		for (int i = 0; i < 8; i++)
		{
			MicroOLEDsetPageAddress(i);
			MicroOLEDsetColumnAddress(0);
			uint8_t zeros[0x80];
			memset(zeros, 0, 0x80);
			for (int j = 0; j < 0x80; j++)
			{
				error= MicroOLEDdata(0);
				if (ERROR_NONE != error){
					return error;
				}
				
			}
			
		}
	}
	else
	{
		memset(screenmemory, 0, sizeof(screenmemory)); // (64 x 48) / 8 = 384
		MicroOLEDdisplay();
	}
	return error;
}

/*****************************************************************************
* @fn
/** \brief Transfer display memory.
    Bulk move the screen buffer to the SSD1306 controller's memory so that images/graphics drawn on the screen buffer will be displayed on the OLED.
* @brief	Initializes the OLED driver
* @details 	Assumes I2C is already initialized

* @return		Returns 0 if no errors.
* @note
*****************************************************************************/
int MicroOLEDdisplay(void)
{
	uint8_t i, j;
int error = NULL;
	for (i = 0; i < 6; i++)
	{
		MicroOLEDsetPageAddress(i);
		MicroOLEDsetColumnAddress(0);
		for (j = 0; j < 0x40; j++)
		{
			error= MicroOLEDdata(screenmemory[i * 0x40 + j]);
			if (ERROR_NONE != error){
				return error;
			}
		}
	}
	return error;
}
/*****************************************************************************
* @fn
/** \brief Set SSD1306 page address.
    Send page address command and address to the SSD1306 OLED controller.
* @brief	Initializes the OLED driver
* @details 	Assumes I2C is already initialized

* @return		Returns 0 if no errors.
* @note
*****************************************************************************/
void MicroOLEDsetPageAddress(uint8_t add)
{
	add = 0xb0 | add;
	MicroOLEDcommand(add);
	return;
}
/*****************************************************************************
* @fn
/** \brief Set SSD1306 column address.
    Send column address command and address to the SSD1306 OLED controller.
* @brief	Initializes the OLED driver
* @details 	Assumes I2C is already initialized

* @return		Returns 0 if no errors.
* @note
*****************************************************************************/
void MicroOLEDsetColumnAddress(uint8_t add)
{
	MicroOLEDcommand((0x10 | (add >> 4)) + 0x02);
	MicroOLEDcommand((0x0f & add));
	return;
}
/*****************************************************************************
* @fn
/** \brief Get LCD width.
    The width of the LCD return as byte.
* @brief	Initializes the OLED driver
* @details 	Assumes I2C is already initialized

* @return		Returns 0 if no errors.
* @note
*****************************************************************************/
uint8_t MicroOLEDgetLCDWidth(void)
{
	return LCDWIDTH;
}


/** \brief Get LCD height.
    The height of the LCD return as byte.
*/
uint8_t MicroOLEDgetLCDHeight(void)
{
	return LCDHEIGHT;
}

/*****************************************************************************
* @fn
		Draw circle with radius using color and mode at x,y of the screen buffer.
* @brief	Initializes the OLED driver
* @details 	Assumes I2C is already initialized

* @return		Returns 0 if no errors.
* @note
*****************************************************************************/
void MicroOLEDcircle(uint8_t x0, uint8_t y0, uint8_t radius, uint8_t color, uint8_t mode)
{

	//TODO - find a way to check for no overlapping of pixels so that XOR draw mode will work perfectly
	int8_t f = 1 - radius;
	int8_t ddF_x = 1;
	int8_t ddF_y = -2 * radius;
	int8_t x = 0;
	int8_t y = radius;

	MicroOLEDpixel(x0, y0 + radius, color, mode);
	MicroOLEDpixel(x0, y0 - radius, color, mode);
	MicroOLEDpixel(x0 + radius, y0, color, mode);
	MicroOLEDpixel(x0 - radius, y0, color, mode);

	while (x < y)
	{
		if (f >= 0)
		{
			y--;
			ddF_y += 2;
			f += ddF_y;
		}
		x++;
		ddF_x += 2;
		f += ddF_x;

		MicroOLEDpixel(x0 + x, y0 + y, color, mode);
		MicroOLEDpixel(x0 - x, y0 + y, color, mode);
		MicroOLEDpixel(x0 + x, y0 - y, color, mode);
		MicroOLEDpixel(x0 - x, y0 - y, color, mode);
		MicroOLEDpixel(x0 + y, y0 + x, color, mode);
		MicroOLEDpixel(x0 - y, y0 + x, color, mode);
		MicroOLEDpixel(x0 + y, y0 - x, color, mode);
		MicroOLEDpixel(x0 - y, y0 - x, color, mode);
	}
}

/*****************************************************************************
* @fn			void MicroOLEDpixel(uint8_t x, uint8_t y, uint8_t color, uint8_t mode)
* @brief		Draw pixel with color and mode.
* @details 		Draw color pixel in the screen buffer's x,y position with NORM or XOR draw mode.
* @return		
* @note
*****************************************************************************/
void MicroOLEDpixel(uint8_t x, uint8_t y, uint8_t color, uint8_t mode)
{
	if ((x < 0) || (x >= LCDWIDTH) || (y < 0) || (y >= LCDHEIGHT))
	return;

	if (mode == XOR)
	{
		if (color == WHITE)
		screenmemory[x + (y / 8) * LCDWIDTH] ^= _BV((y % 8));
	}
	else
	{
		if (color == WHITE)
		screenmemory[x + (y / 8) * LCDWIDTH] |= _BV((y % 8));
		else
		screenmemory[x + (y / 8) * LCDWIDTH] &= ~_BV((y % 8));
	}
}
/*****************************************************************************
* @fn		void MicroOLEDsetDrawMode(uint8_t mode)
* @brief	Set draw mode.
* @details 	Set current draw mode with NORM or XOR.
* @return		
* @note
*****************************************************************************/
void MicroOLEDsetDrawMode(uint8_t mode)
{
	drawMode = mode;
}
/*****************************************************************************
* @fn		void MicroOLEDsetCursor(uint8_t x, uint8_t y)
* @brief	Set cursor position.
* @details 	MicroOLED's cursor position to x,y.

* @return		
* @note
*****************************************************************************/
void MicroOLEDsetCursor(uint8_t x, uint8_t y)
{
	cursorX = x;
	cursorY = y;
}
/*****************************************************************************
* @fn		uint8_t MicroOLEDsetFontType(uint8_t type)
* @brief	Set font type.
* @details 	Set the current font type number, ie changing to different fonts base on the type provided.

* @return
* @note
*****************************************************************************/
uint8_t MicroOLEDsetFontType(uint8_t type)
{
    if ((type >= MAXFONTS) || (fontsPointer[type] == NULL))
        return false;

	fontType = type;
	fontWidth = *(fontsPointer[fontType] + 0);
	fontHeight = *(fontsPointer[fontType] + 1);
	fontStartChar = *(fontsPointer[fontType] + 2);
	fontTotalChar = *(fontsPointer[fontType] + 3);
	fontMapWidth = (*(fontsPointer[fontType] + 4) * 100) + *(fontsPointer[fontType] + 5); // two bytes values into integer 16
	return true;
}
/*****************************************************************************
* @fn		void MicroOLEDsetColor(uint8_t color)
* @brief	Set color.
* @details 	Set the current draw's color. Only WHITE and BLACK available.

* @return		Returns 0 if no errors.
* @note
*****************************************************************************/
void MicroOLEDsetColor(uint8_t color)
{
	foreColor = color;
}




/*****************************************************************************
* @fn		void MicroOLEDdrawChar(uint8_t x, uint8_t y, uint8_t c, uint8_t color, uint8_t mode)
* @brief	Draw character with color and mode.
* @details 	Draw character c using color and draw mode at x,y.

* @return	
* @note
*****************************************************************************/
void MicroOLEDdrawChar(uint8_t x, uint8_t y, uint8_t c, uint8_t color, uint8_t mode)
{
	// TODO - New routine to take font of any height, at the moment limited to font height in multiple of 8 pixels

	uint8_t rowsToDraw, row, tempC;
	uint8_t i, j, temp;
	uint16_t charPerBitmapRow, charColPositionOnBitmap, charRowPositionOnBitmap, charBitmapStartPosition;

	if ((c < fontStartChar) || (c > (fontStartChar + fontTotalChar - 1))) // no bitmap for the required c
		return;

	tempC = c - fontStartChar;

	// each row (in datasheet is call page) is 8 bits high, 16 bit high character will have 2 rows to be drawn
	rowsToDraw = fontHeight / 8; // 8 is LCD's page size, see SSD1306 datasheet
	if (rowsToDraw <= 1)
		rowsToDraw = 1;

	// the following draw function can draw anywhere on the screen, but SLOW pixel by pixel draw
	if (rowsToDraw == 1)
	{
		for (i = 0; i < fontWidth + 1; i++)
		{
			if (i == fontWidth) // this is done in a weird way because for 5x7 font, there is no margin, this code add a margin after col 5
				temp = 0;
			else
				temp = *(fontsPointer[fontType] + FONTHEADERSIZE + (tempC * fontWidth) + i);

			for (j = 0; j < 8; j++)
			{ // 8 is the LCD's page height (see datasheet for explanation)
				if (temp & 0x1)
				{
					MicroOLEDpixel(x + i, y + j, color, mode);
				}
				else
				{
					MicroOLEDpixel(x + i, y + j, !color, mode);
				}

				temp >>= 1;
			}
		}
		return;
	}

	// font height over 8 bit
	// take character "0" ASCII 48 as example
	charPerBitmapRow = fontMapWidth / fontWidth;			 // 256/8 =32 char per row
	charColPositionOnBitmap = tempC % charPerBitmapRow;		 // =16
	charRowPositionOnBitmap = (int)(tempC / charPerBitmapRow); // =1
	charBitmapStartPosition = (charRowPositionOnBitmap * fontMapWidth * (fontHeight / 8)) + (charColPositionOnBitmap * fontWidth);

	// each row on LCD is 8 bit height (see datasheet for explanation)
	for (row = 0; row < rowsToDraw; row++)
	{
		for (i = 0; i < fontWidth; i++)
		{
			temp = *(fontsPointer[fontType] + FONTHEADERSIZE + (charBitmapStartPosition + i + (row * fontMapWidth)));
			for (j = 0; j < 8; j++)
			{ // 8 is the LCD's page height (see datasheet for explanation)
				if (temp & 0x1)
				{
					MicroOLEDpixel(x + i, y + j + (row * 8), color, mode);
				}
				else
				{
					MicroOLEDpixel(x + i, y + j + (row * 8), !color, mode);
				}
				temp >>= 1;
			}
		}
	}
}
/*****************************************************************************
* @fn		void MicroOLEDwrite(uint8_t c)
* @brief	write character.
* @details 	Draw character c using color and draw mode at x,y.

* @return	
* @note
*****************************************************************************/
void MicroOLEDwrite(uint8_t c)
{
	if (c == '\n')
	{
		cursorY += fontHeight;
		cursorX = 0;
	}
	else if (c == '\r')
	{
		// skip
	}
	else
	{
		MicroOLEDdrawChar(cursorX, cursorY, c, foreColor, drawMode);
		cursorX += fontWidth + 1;
		if ((cursorX > (LCDWIDTH - fontWidth)))
		{
			cursorY += fontHeight;
			cursorX = 0;
		}
	}

	return 1;
}

void MicroOLEDdrawBitmap(uint8_t *bitArray)
{
	MicroOLEDclear(!ALL);
	for (int i = 0; i < (LCDWIDTH * LCDHEIGHT / 8); i++)
	screenmemory[i] = bitArray[i];
	MicroOLEDdisplay();
}

void MicroOLEDdrawWinner(){
	MicroOLEDdrawBitmap(winner);
	
}

void MicroOLEDdrawLoser(){
	MicroOLEDdrawBitmap(loser);
}

void MicroOLEDdrawTurns(){
	MicroOLEDdrawBitmap(Turns);
}

void MicroOLEDdrawWait(){
	MicroOLEDdrawBitmap(WAIT);
}
