Kenny-Z/ESE516Group/(commit log)

2021-04-09 故障还原
2021-04-21 Light sensor + CLI + OLED
2021-05-13 add altium
    [5V5_BOOST.SchDoc, 5V5to3V3Buck.SchDoc, Bill of Materials-ESE516_ExampleProject.xlsx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]
